gdgly/itr-201c/README.md

#ITR-201C
* 该项目是定制产品，产品名称为*变压器免维护呼吸器*，型号为*ITR-201C*。
* 目前产品设计到_V2.0_版本，按照新的需求，增加了液晶显示等内容，
  并且将核心板由原来的ARM9改为Cortex-A8。
