gdgly/itr-201c/SCH_160725/ITR-201C_FB_V20_160725/Visio-面板示意图_160726.pdf

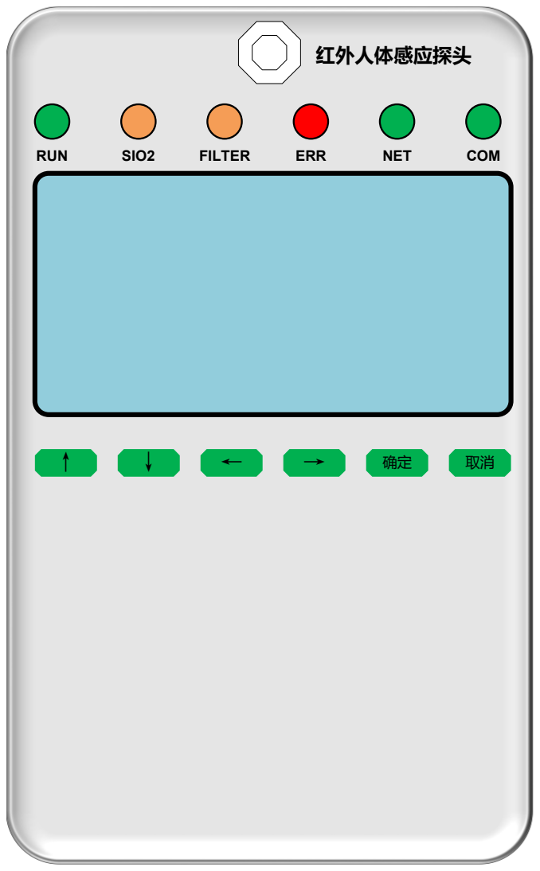
[picture p2: figure]
RUN; SIO2; FILTER; ERR; NET; COM; 红外人体感应探头

说明：
1、面板上一共配置6路指示灯，均采用直径
3mm指示灯。指示灯定义为：
RUN：运行指示灯
SIO2：硅胶加热器加热指示灯
FILTER：金属滤网加热器加热指示灯
ERR：系统错误指示灯
NET：以太网通讯指示灯
COM：RS485通讯指示灯
2、液晶屏采用3.5吋TFT真彩屏。
3、按键一共6个，分别为：
上、下、左、右和确定、取消键。
4、红外人体感应探头为白色圆形。当探测到
人体遮挡时，自动点亮液晶屏。
