gdgly/itr-201c/结构图_161019/ITR-201C_FB.dxf

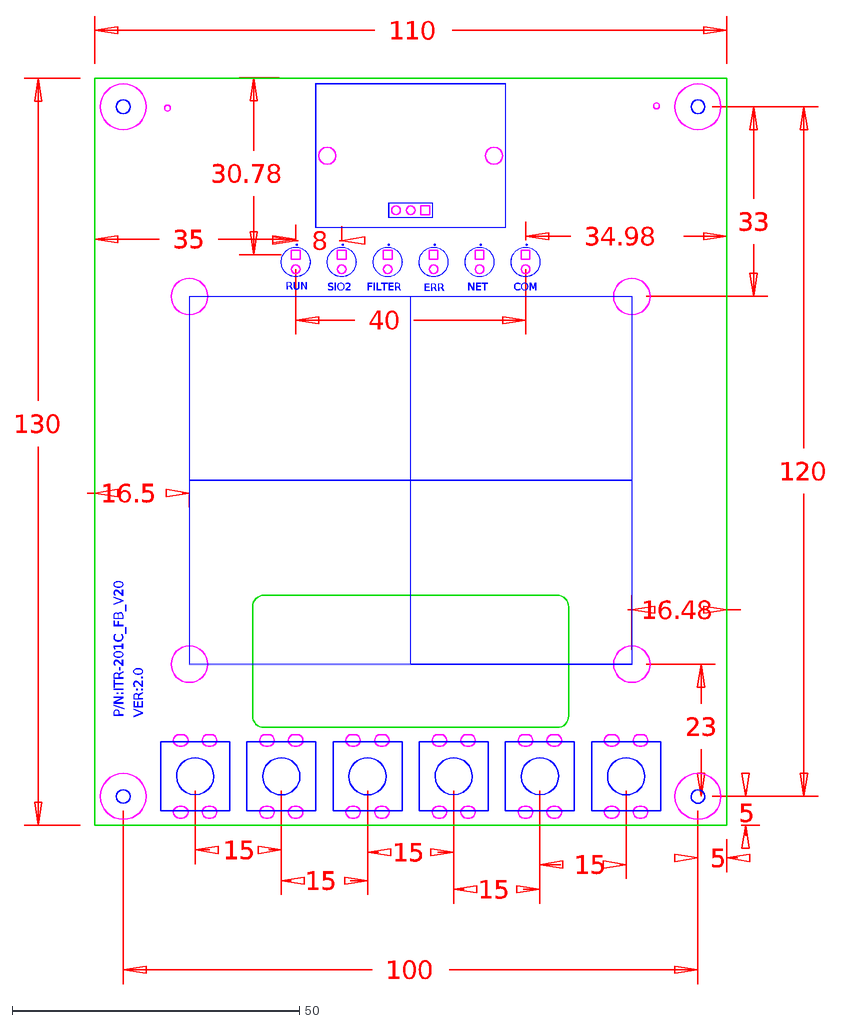
[picture p3: CAD file, 2016-10-24]
结构图_161019/ITR-201C_FB.dxf
33
5
23
30.78
35
34.98
40
8
16.5
16.48
120
100
15
110
130
COM
NET
ERR
FILTER
SIO2
RUN
VER:2.0
P/N:ITR-201C_FB_V20
