gdgly/itr-201c/SCH_160725/ITR-201C_FB_V20_160725/itr-201c_fb_V2.0_160812.pdf

D | D
C | C
B | B
A | A
2.0 | FEATURE CHANGES 1、产品升级至V2.0版。 2、需要增加液晶显示电路。整体架构重新设计。 | 07/23/16 | Jason
REV | DESCRIPTION | DATE | BY
1.0 | 04/20/16 | Jason

## Jason

# CONTENTS

PAGE NO. | SCHEMATIC PAGE
1 | 封面
2 | 接插件：1 * 40pin 双排2.54mm简牛插针
3 | LCD液晶屏电路
4 | 矩阵键盘电路
5 | LED指示灯输出电路
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
标记 标记 标记 | 数量更改单号签名日期 更改 数量更改单号签名日期 更改 数量更改单号签名日期 更改 | | | 更改 更改 更改 标记 标记 标记 | 数量更改单号 数量更改单号 数量更改单号 | | 签名 签名日期 更改标记 数量更改单号 签名 签名日期 更改标记 数量更改单号 签名 签名日期 更改标记 数量更改单号 | 日期 日期 日期
拟制 拟制 拟制 | | Jason.Wang Jason.Wang Jason.Wang | COVER COVER COVER | | | ITR-201C ITR-201C ITR-201C
审核 审核 审核 | | <审核> <审核> <审核>
批准 | <批准>
版本 | 第　　张 | 共　　张
V2.0 V2.0 V2.0 | 1 1 1 | 5 5 5

# 标准化

D | D

# 采用40pin双排简牛插座

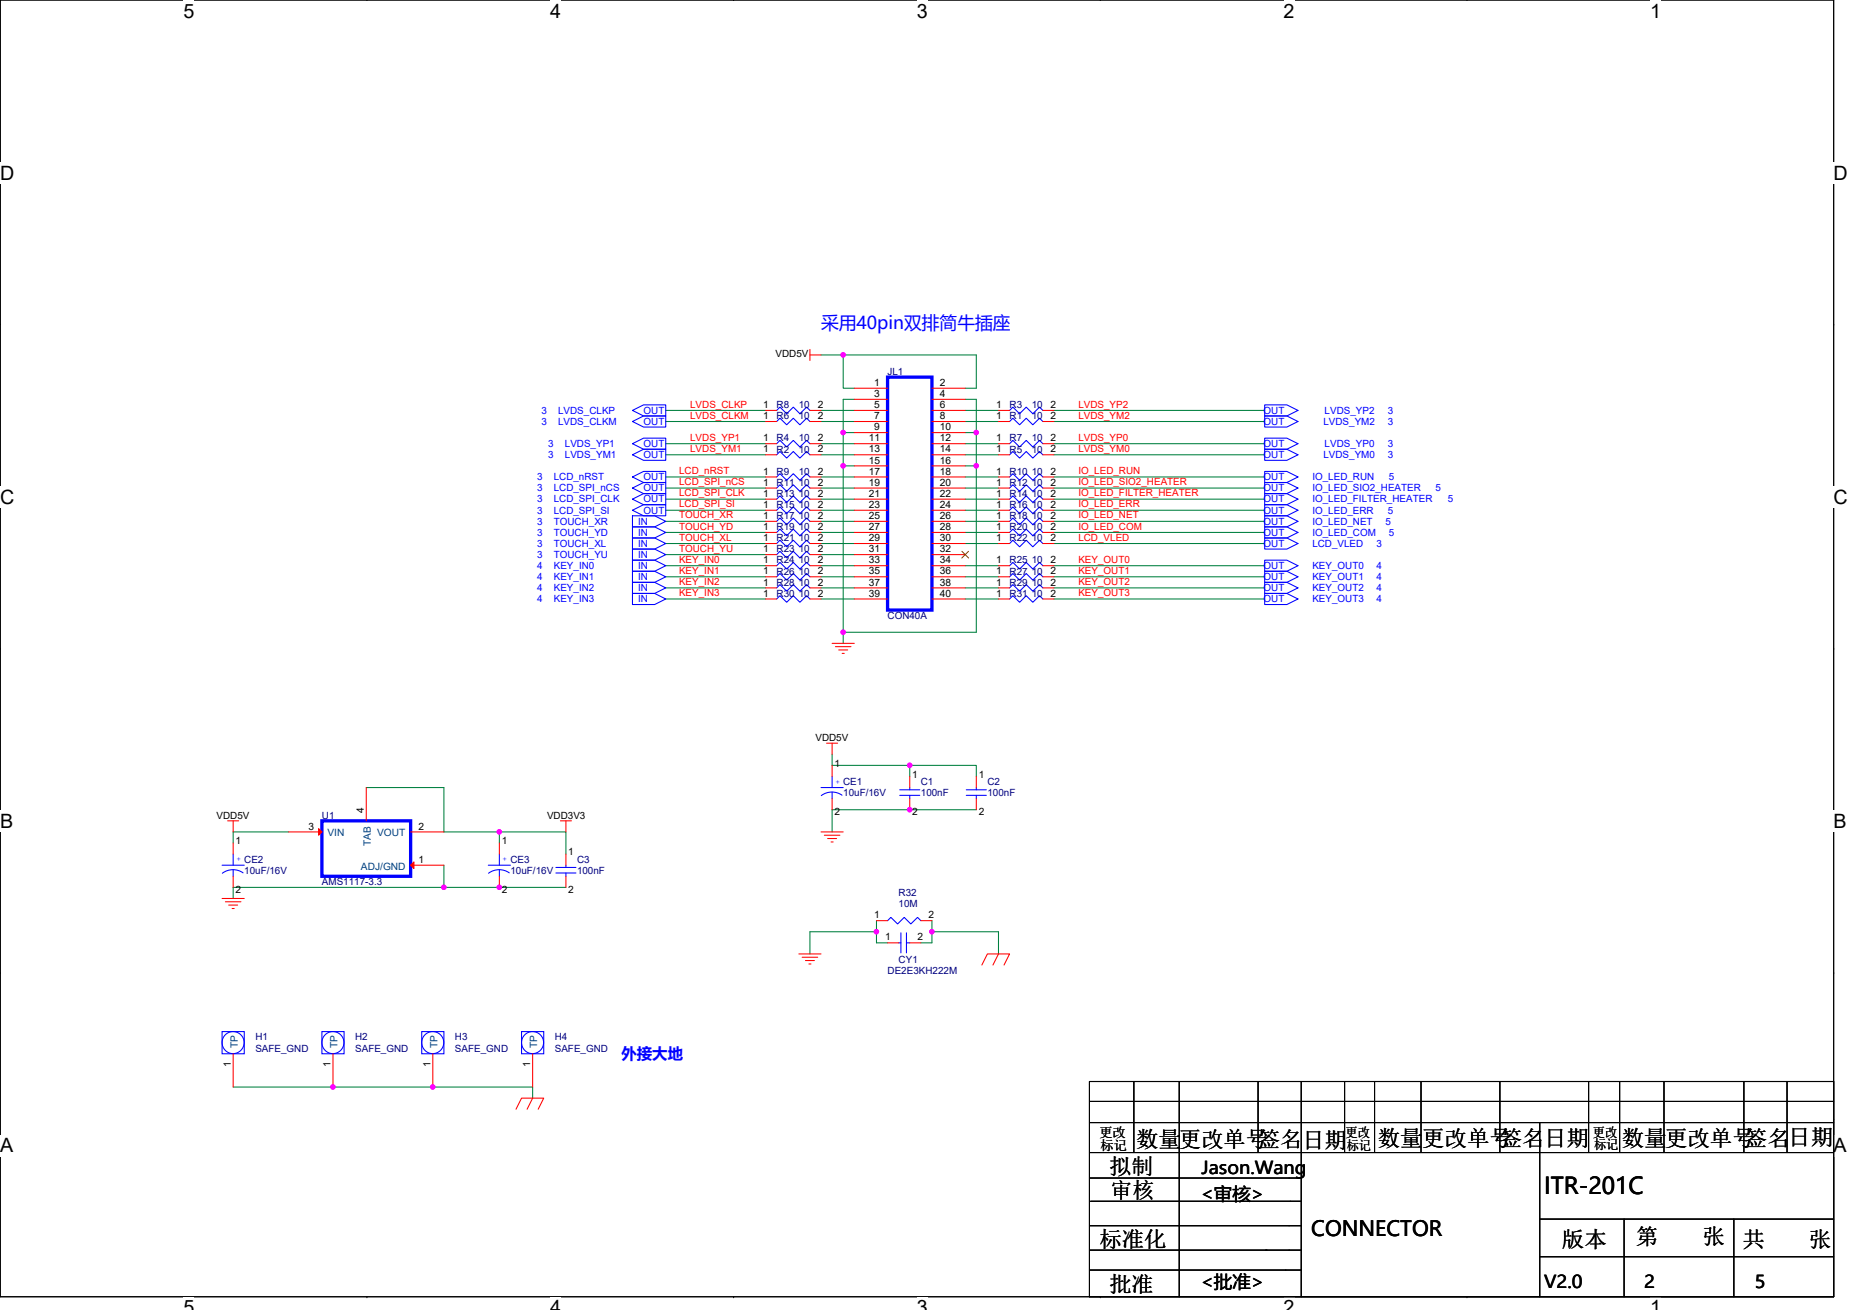
[picture p4: page 2]

标记 标记 标记 | 数量更改单号签名日期 更改 数量更改单号签名日期 更改 数量更改单号签名日期 更改 | | | 更改 更改 更改 标记 标记 标记 | 数量更改单号 数量更改单号 数量更改单号 | | 签名 签名日期 更改标记 数量更改单号 签名 签名日期 更改标记 数量更改单号 签名 签名日期 更改标记 数量更改单号 | 日期 日期 日期
拟制 拟制 拟制 | | Jason.Wang Jason.Wang Jason.Wang | CONNECTOR CONNECTOR CONNECTOR | | | ITR-201C ITR-201C ITR-201C
审核 审核 审核 | | <审核> <审核> <审核>

D | D
D0 24 | GND | 25 D1 | 26 D2 | 27 VCC | 28 D3 | 29 D4 | 30 D5 | 31 GND | 32 D6 | 33 D7 | 34 D8 | 35 VCC | 36 D9 | 37 GND | 38 D10 | 39 D11 | 40 D12 | 41 VCC | 42 D13 | 43 GND | 44 D14 | 45 D15 | 46 D16 | 47 VCC | 48

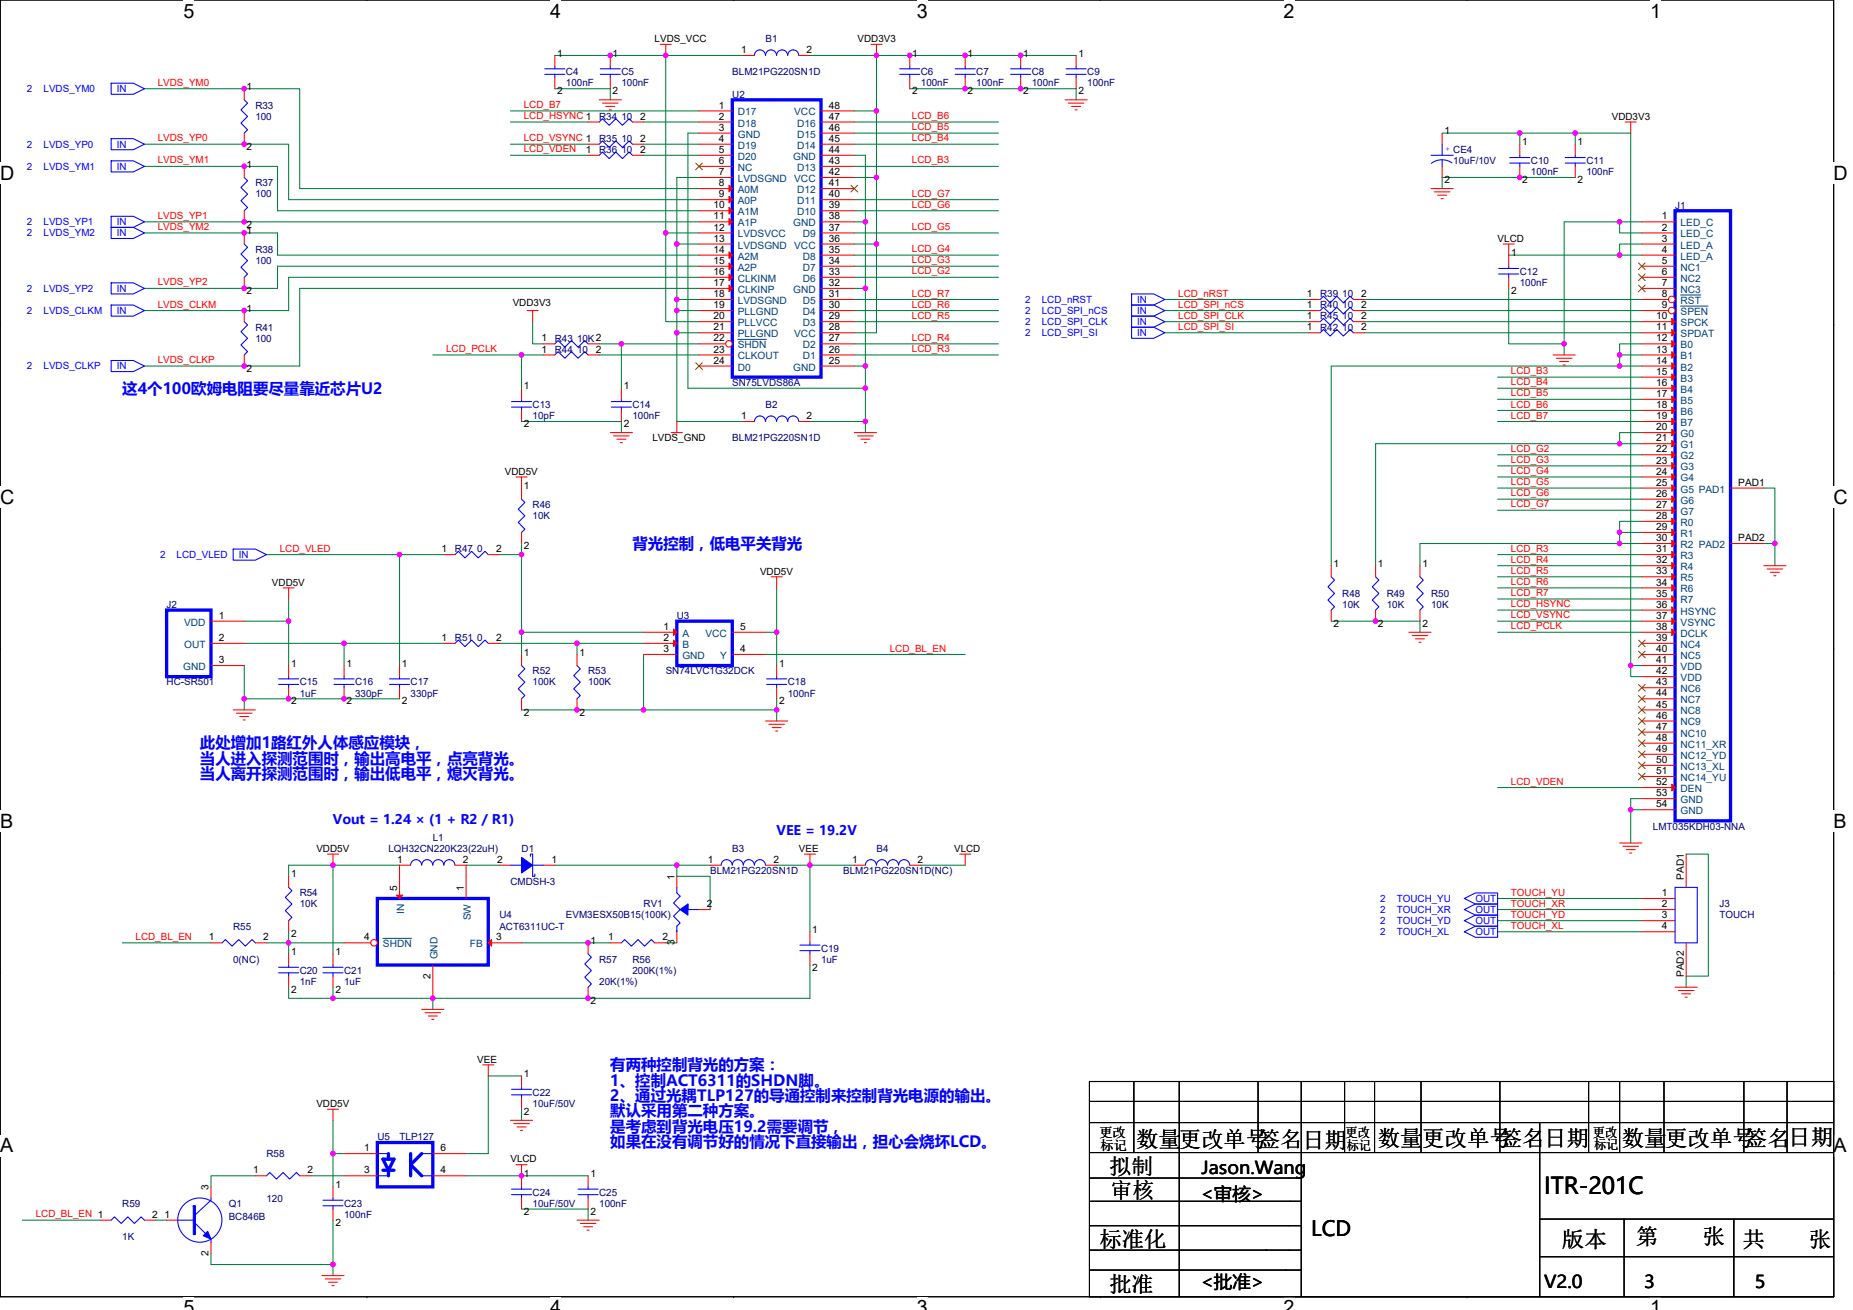
[picture p5: page 3]

CLKINM 16

VDD3V3 | LVDSGND 18

标记 标记 标记 | 数量更改单号签名日期 更改 数量更改单号签名日期 更改 数量更改单号签名日期 更改 | | | 更改 更改 更改 标记 标记 标记 | 数量更改单号 数量更改单号 数量更改单号 | | 签名 签名日期 更改标记 数量更改单号 签名 签名日期 更改标记 数量更改单号 签名 签名日期 更改标记 数量更改单号 | 日期 日期 日期
拟制 拟制 拟制 | | Jason.Wang Jason.Wang Jason.Wang | LCD LCD LCD | | | ITR-201C ITR-201C ITR-201C
审核 审核 审核 | | <审核> <审核> <审核>

D | D

# KEYBOARD

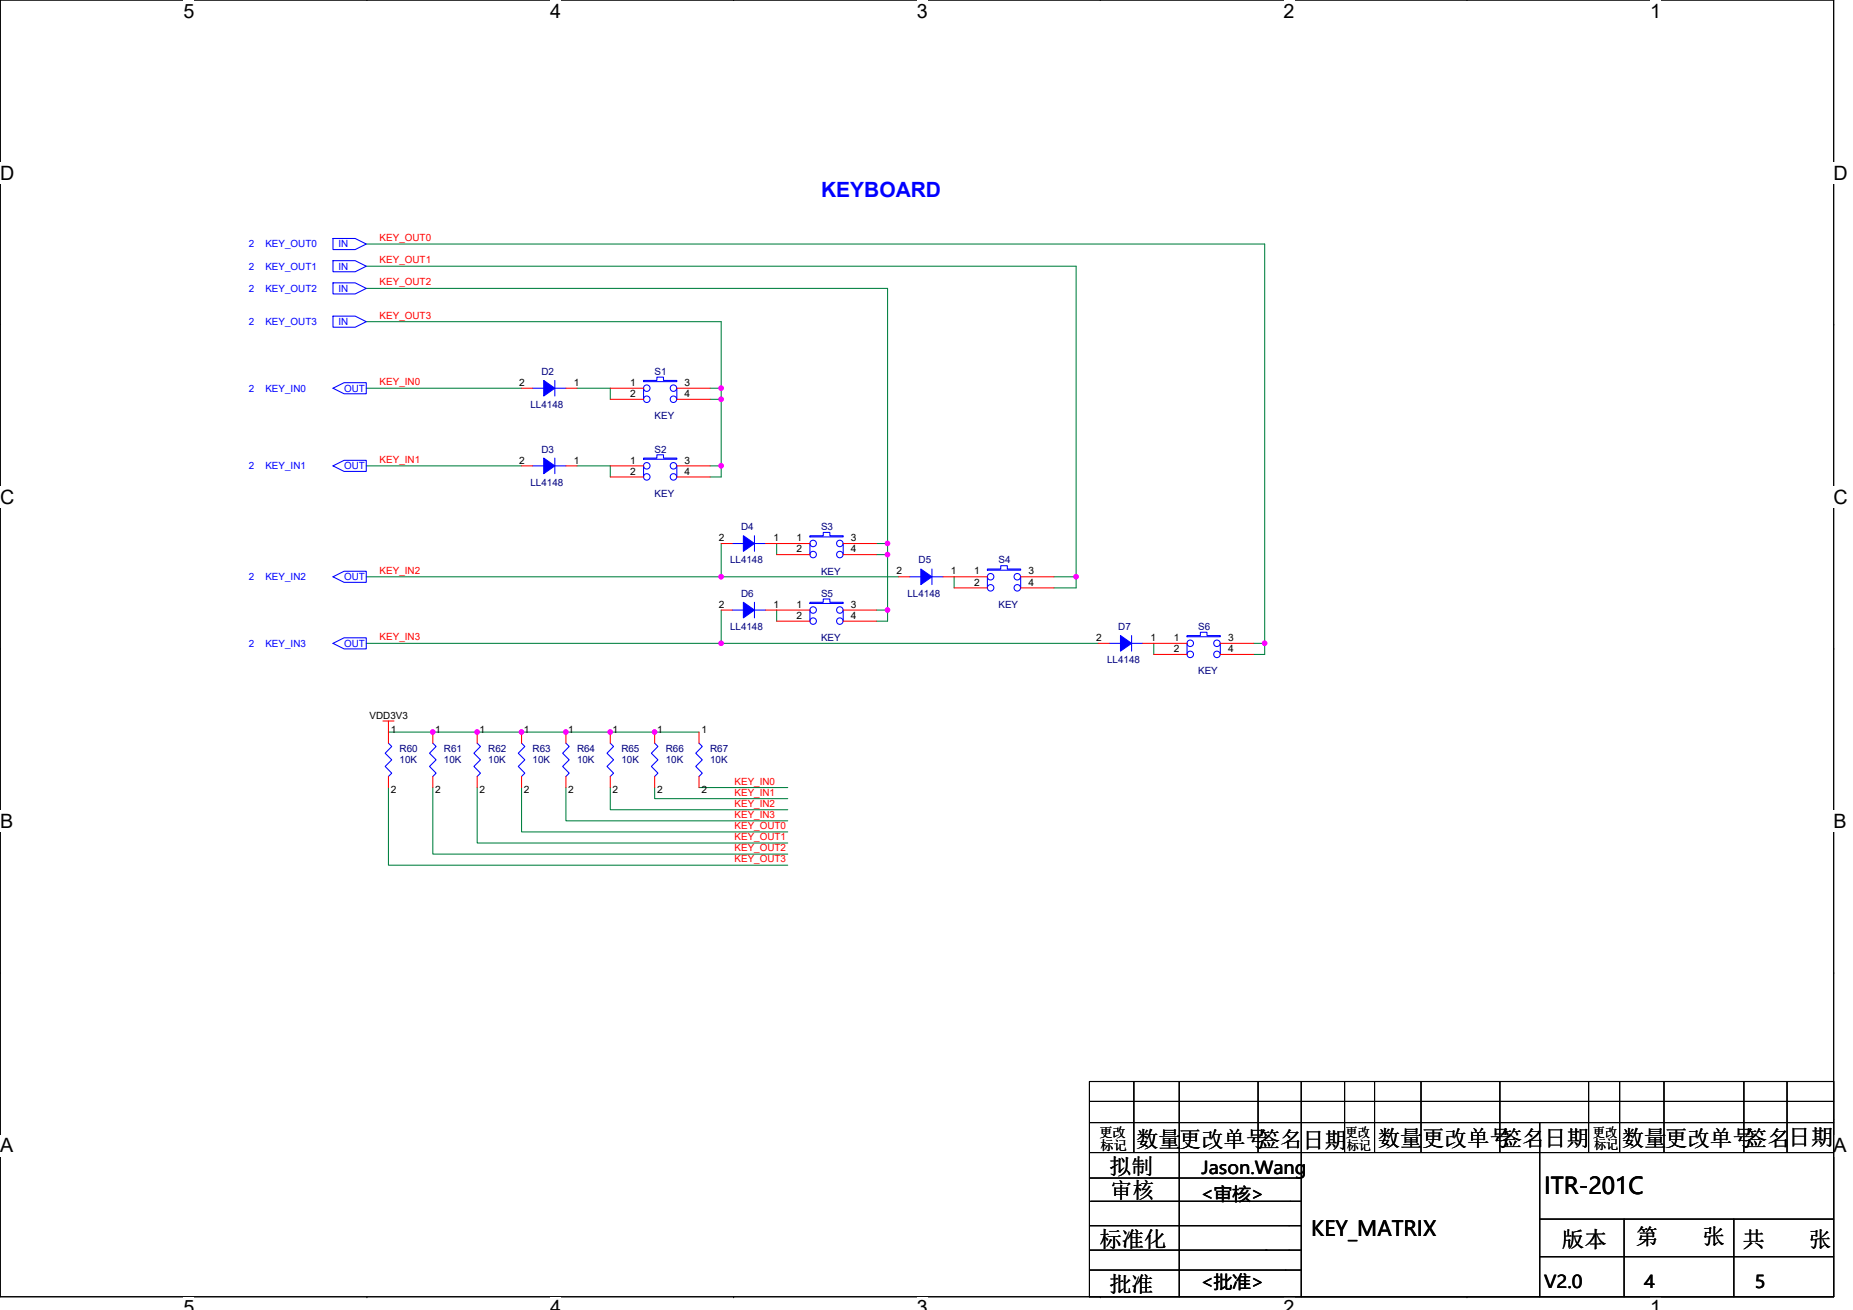
[picture p6: page 4]

标记 标记 标记 | 数量更改单号签名日期 更改 数量更改单号签名日期 更改 数量更改单号签名日期 更改 | | | 更改 更改 更改 标记 标记 标记 | 数量更改单号 数量更改单号 数量更改单号 | | 签名 签名日期 更改标记 数量更改单号 签名 签名日期 更改标记 数量更改单号 签名 签名日期 更改标记 数量更改单号 | 日期 日期 日期
拟制 拟制 拟制 | | Jason.Wang Jason.Wang Jason.Wang | KEY_MATRIX KEY_MATRIX KEY_MATRIX | | | ITR-201C ITR-201C ITR-201C
审核 审核 审核 | | <审核> <审核> <审核>

D | D

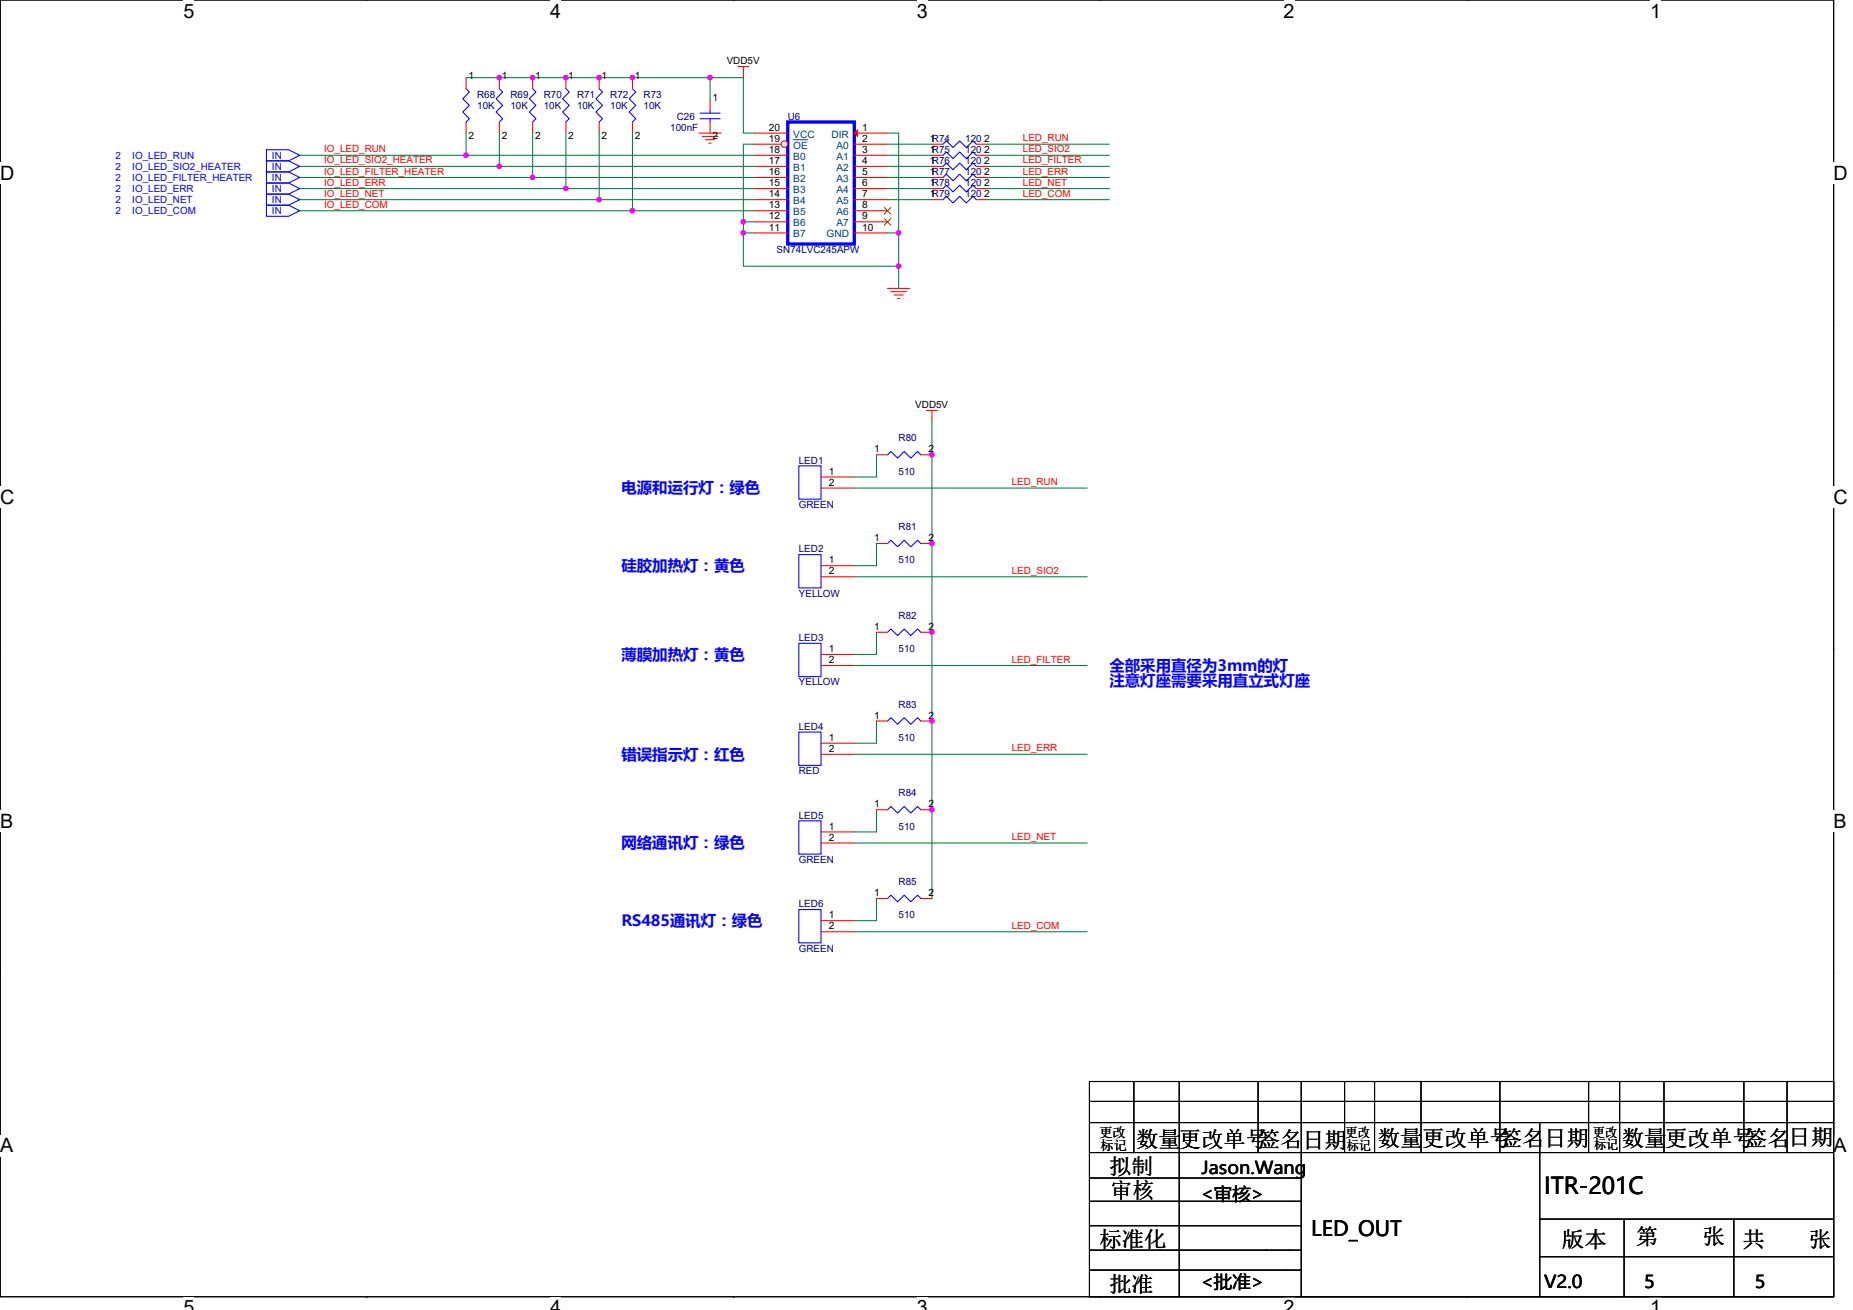
[picture p7: page 5]

标记 标记 标记 | 数量更改单号签名日期 更改 数量更改单号签名日期 更改 数量更改单号签名日期 更改 | | | 更改 更改 更改 标记 标记 标记 | 数量更改单号 数量更改单号 数量更改单号 | | 签名 签名日期 更改标记 数量更改单号 签名 签名日期 更改标记 数量更改单号 签名 签名日期 更改标记 数量更改单号 | 日期 日期 日期
拟制 拟制 拟制 | | Jason.Wang Jason.Wang Jason.Wang | LED_OUT LED_OUT LED_OUT | | | ITR-201C ITR-201C ITR-201C
审核 审核 审核 | | <审核> <审核> <审核>
