gdgly/itr-201c/SCH_160725/ITR-201C_MB_V20_160727/ITR-201C_MB_V20_160727.pdf

D | D
C | C
B | B
A | A

1.1

1.0 | FEATURE CHANGES 1、完成1.0版本原理图设计。 | 07/27/16 | Jason
REV | DESCRIPTION | DATE | BY

# CONTENTS

PAGE NO. | SCHEMATIC PAGE
1 | 封面
2 | 系统逻辑框图
3 | 核心板接插件1：LOCAL_BUS
4 | 核心板接插件2：各种外设
5 | 地址线/数据线扩展
6 | CPLD：采用EPM570
7 | LVDS 显示驱动电路
8 | 一路以太网PHY：采用KSZ8041FTL
9 | RJ45
10 | RS485接口电路
11 | 温湿度检测电路
12 | 继电器控制电路
13 | 继电器输出接口电路
14 | 到面板40pin接口
15 | 其它接口电路
16 | 系统输入电源电路
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
标记 标记 标记 | 数量更改单号签名日期 更改 数量更改单号签名日期 更改 数量更改单号签名日期 更改 | | | 更改 更改 更改 标记 标记 标记 | 数量更改单号 数量更改单号 数量更改单号 | | 签名 签名日期 更改标记 数量更改单号 签名 签名日期 更改标记 数量更改单号 签名 签名日期 更改标记 数量更改单号 | 日期 日期 日期
拟制 拟制 拟制 | | Jason.Wang Jason.Wang Jason.Wang | COVER COVER COVER | | | ITR-201C ITR-201C ITR-201C
审核 审核 审核 | | <审核> <审核> <审核>
批准 | <批准>
版本 | 第　　张 | 共　　张
V2.0 V2.0 V2.0 | 1 1 1 | 16 16 16

# 标准化

D | D
C | C
B | B
A | A
LOCAL_BUS | SWA3300

# LVDS

# KSZ8041FTL

# CPLD EPM570T144

# TEMP & HUMIDITY

# DIO

# DO X 4

RJ45

USB 2.0 | USB
UART X 2 | RS485
标记 标记 标记 | 数量更改单号签名日期 更改 数量更改单号签名日期 更改 数量更改单号签名日期 更改 | | | 更改 更改 更改 标记 标记 标记 | 数量更改单号 数量更改单号 数量更改单号 | | 签名 签名日期 更改标记 数量更改单号 签名 签名日期 更改标记 数量更改单号 签名 签名日期 更改标记 数量更改单号 | 日期 日期 日期
拟制 拟制 拟制 | | Jason.Wang Jason.Wang Jason.Wang | SYS_LOGIC SYS_LOGIC SYS_LOGIC | | | ITR-201C ITR-201C ITR-201C
审核 审核 审核 | | <审核> <审核> <审核>
V2.0 | 2 | 16
V2.0 | 2 | 16
V2.0 | 2 | 16

D | D

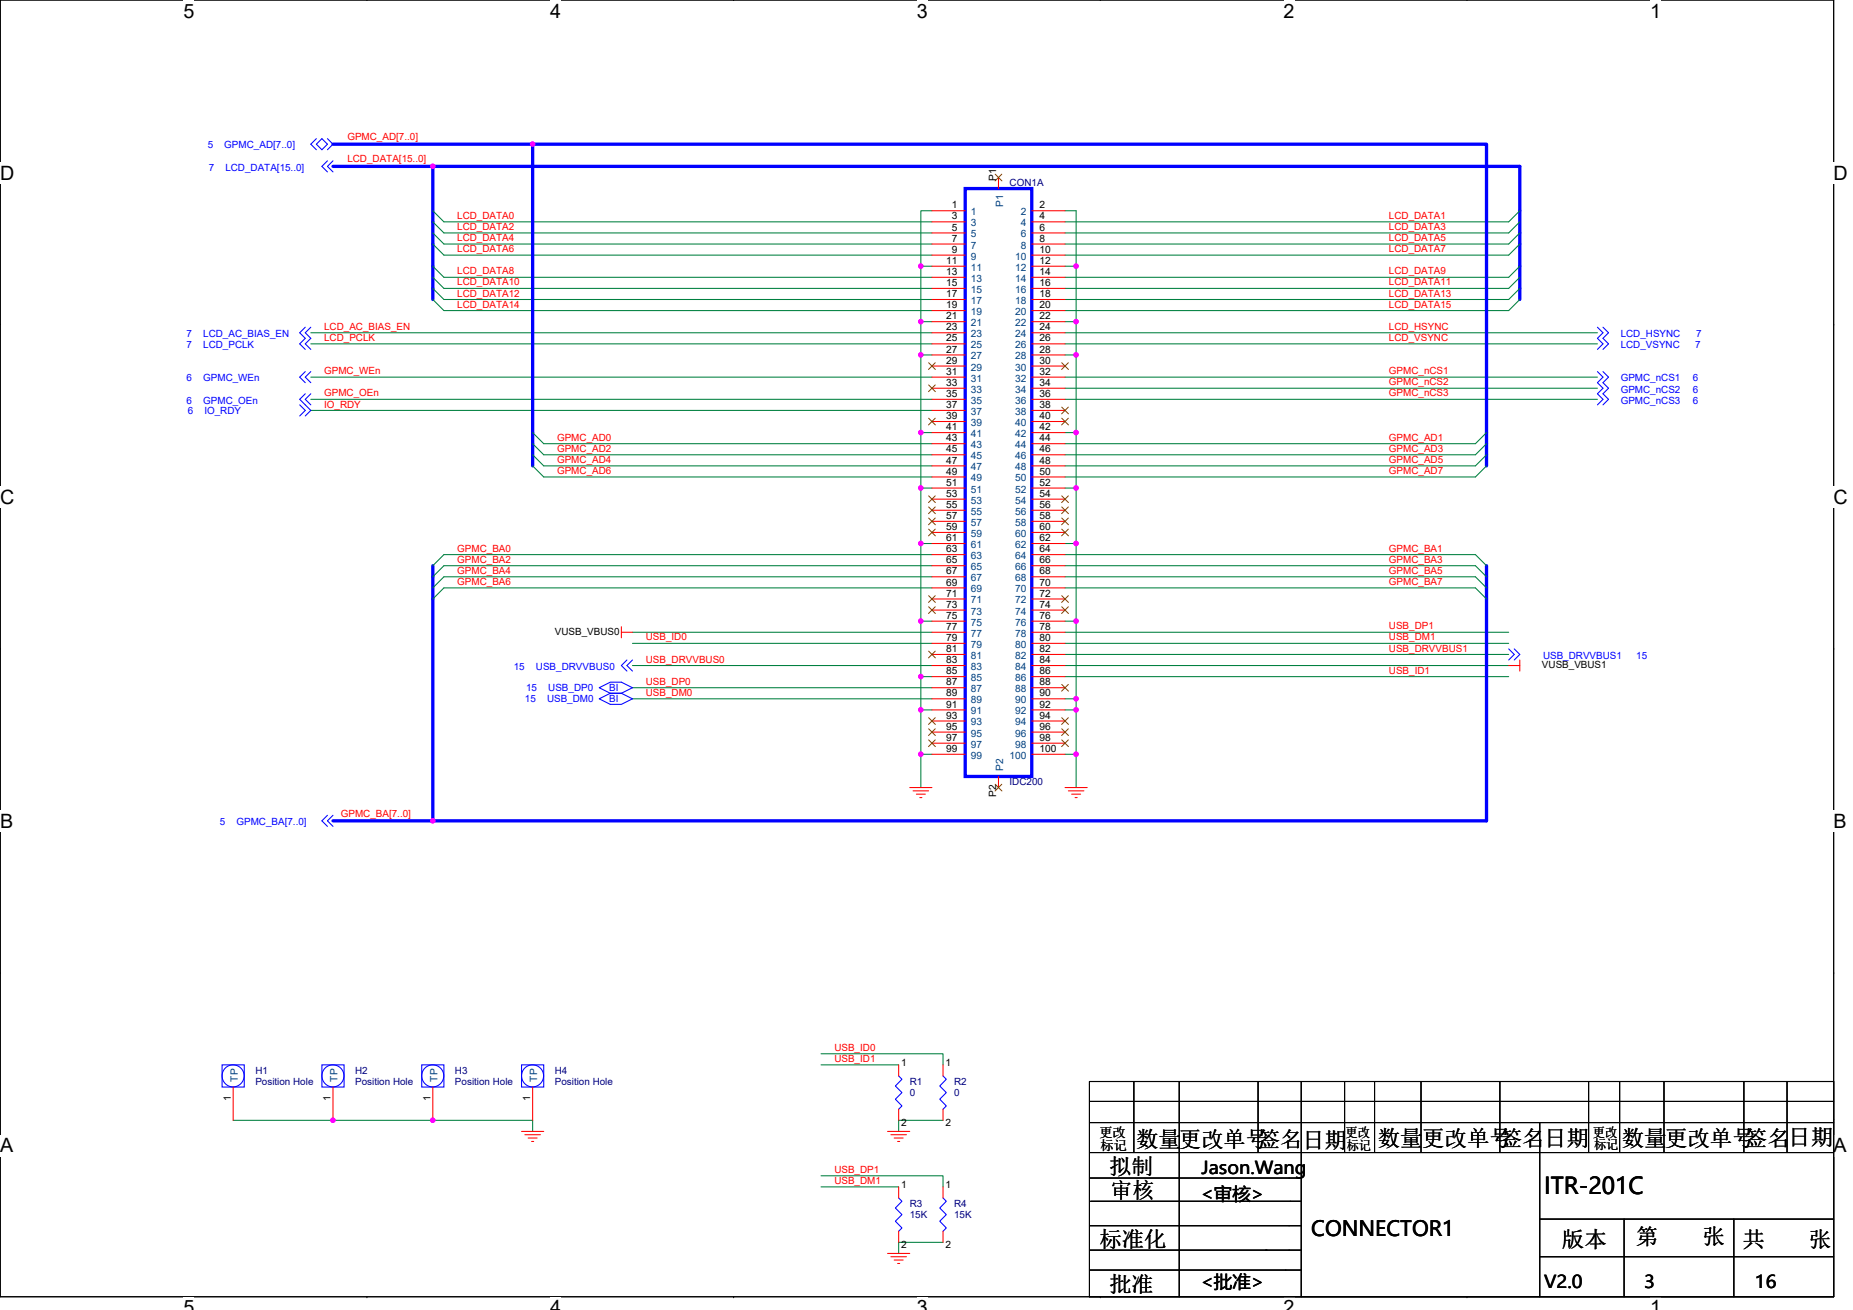
[picture p8: page 3]
USB_ID1; USB_ID0; LCD_DATA0 LCD_DATA2 LCD_DATA4 LCD_DATA6; LCD_DATA8 LCD_DATA10 LCD_DATA12 LCD_DATA14; LCD_DATA9 LCD_DATA11 LCD_DATA13 LCD_DATA15; LCD_DATA1 LCD_DATA3 LCD_DATA5 LCD_DATA7; LCD_DATA[15..0]; LCD_PCLK; LCD_AC_BIAS_EN; LCD_HSYNC; LCD_VSYNC; GPMC_WEn; GPMC_OEn IO_RDY; GPMC_nCS1 GPMC_nCS2 GPMC_nCS3; GPMC_AD0 GPMC_AD2 GPMC_AD4 GPMC_AD6; GPMC_AD1 GPMC_AD3 GPMC_AD5 GPMC_AD7; GPMC_AD[7..0]; USB_DRVVBUS0; USB_DP0 USB_DM0; GPMC_BA0 GPMC_BA2; GPMC_BA6; GPMC_BA4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

Position Hole TP

拟制 拟制 拟制 | Jason.Wang Jason.Wang Jason.Wang | CONNECTOR1 CONNECTOR1 CONNECTOR1 | ITR-201C ITR-201C ITR-201C
审核 审核 审核 | <审核> <审核> <审核>

D | D

注意：

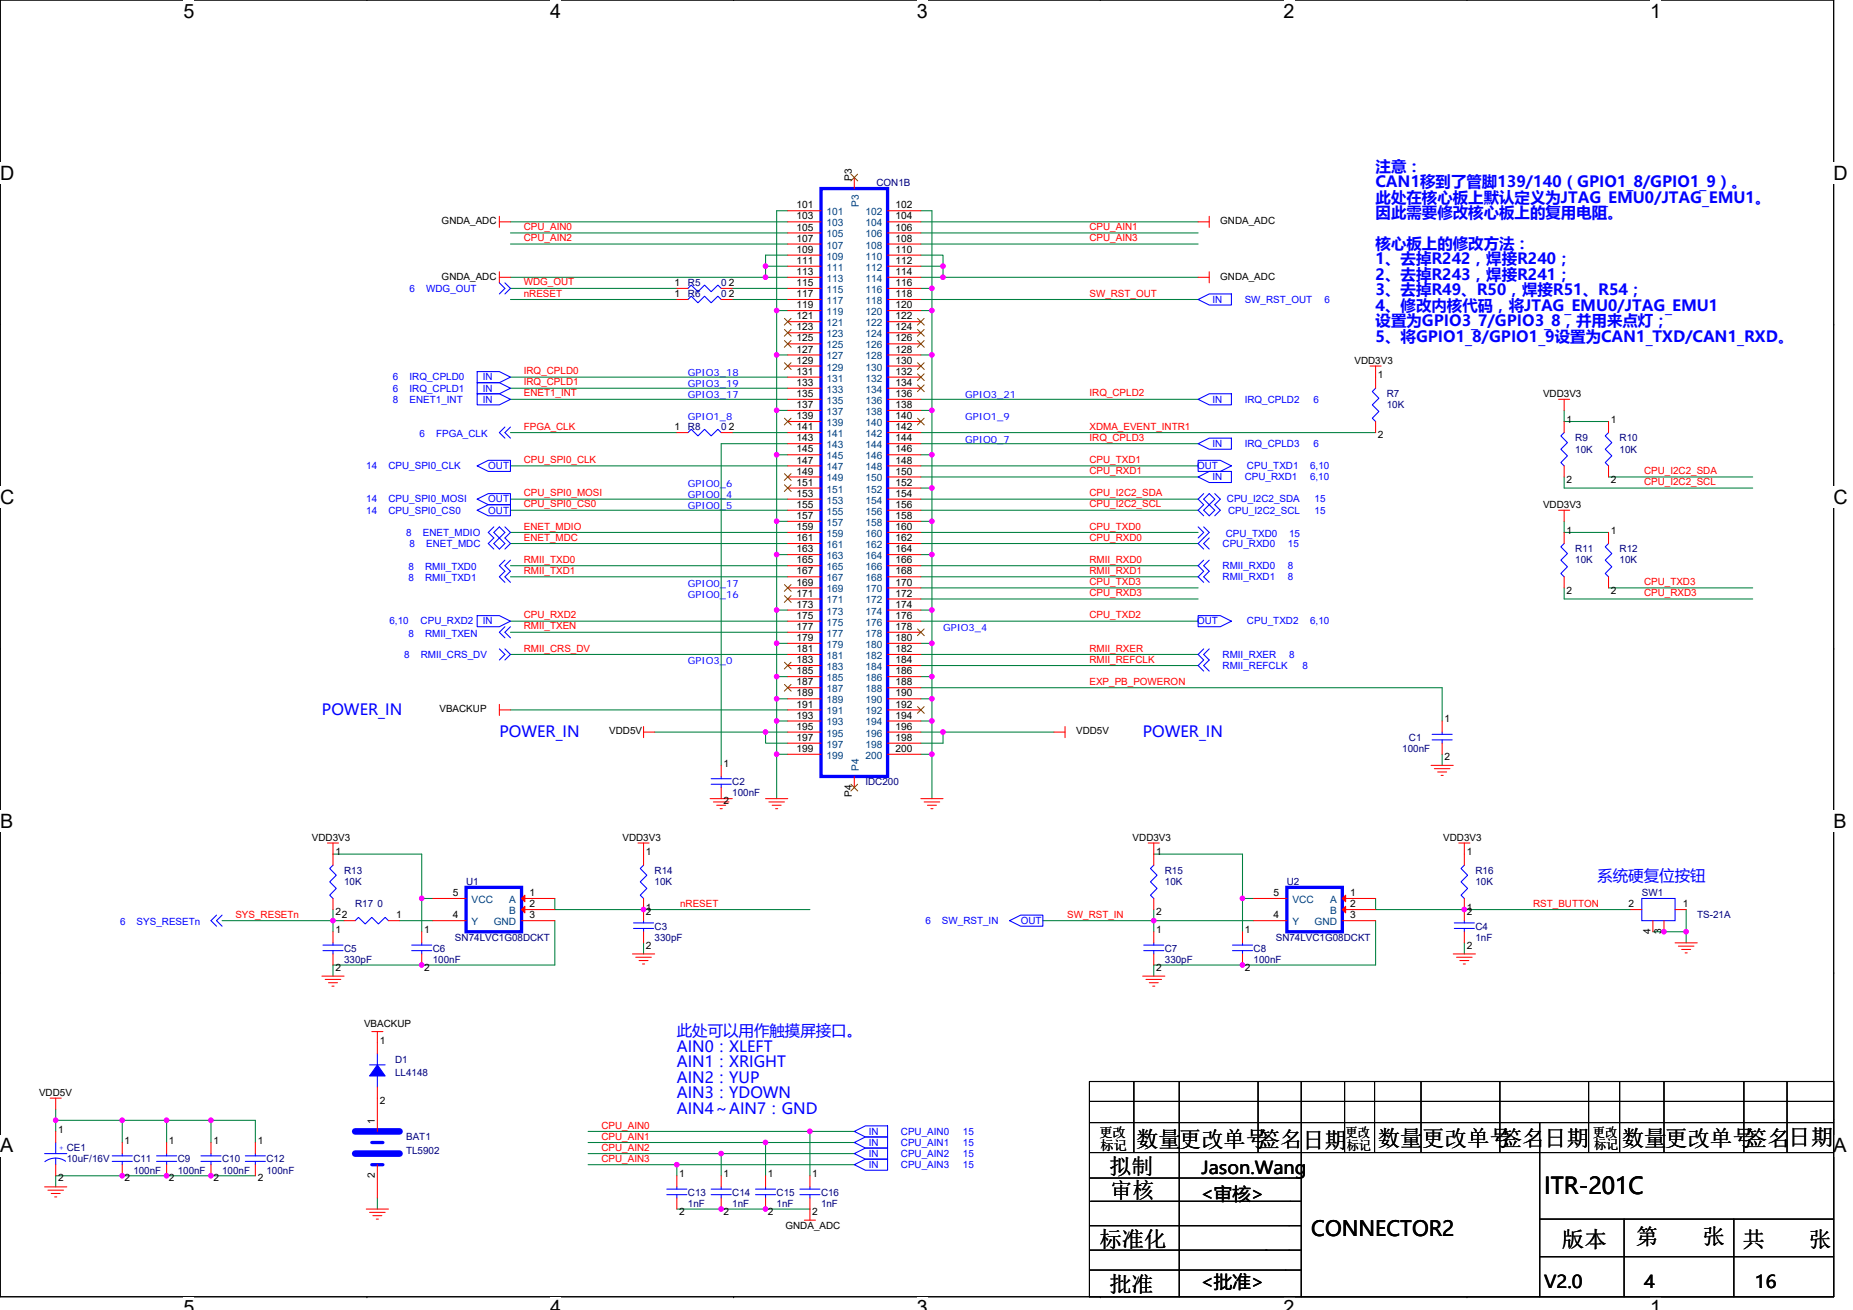
[picture p9: page 4]

拟制 拟制 拟制 | Jason.Wang Jason.Wang Jason.Wang | CONNECTOR2 CONNECTOR2 CONNECTOR2 | ITR-201C ITR-201C ITR-201C
审核 审核 审核 | <审核> <审核> <审核>

D | D

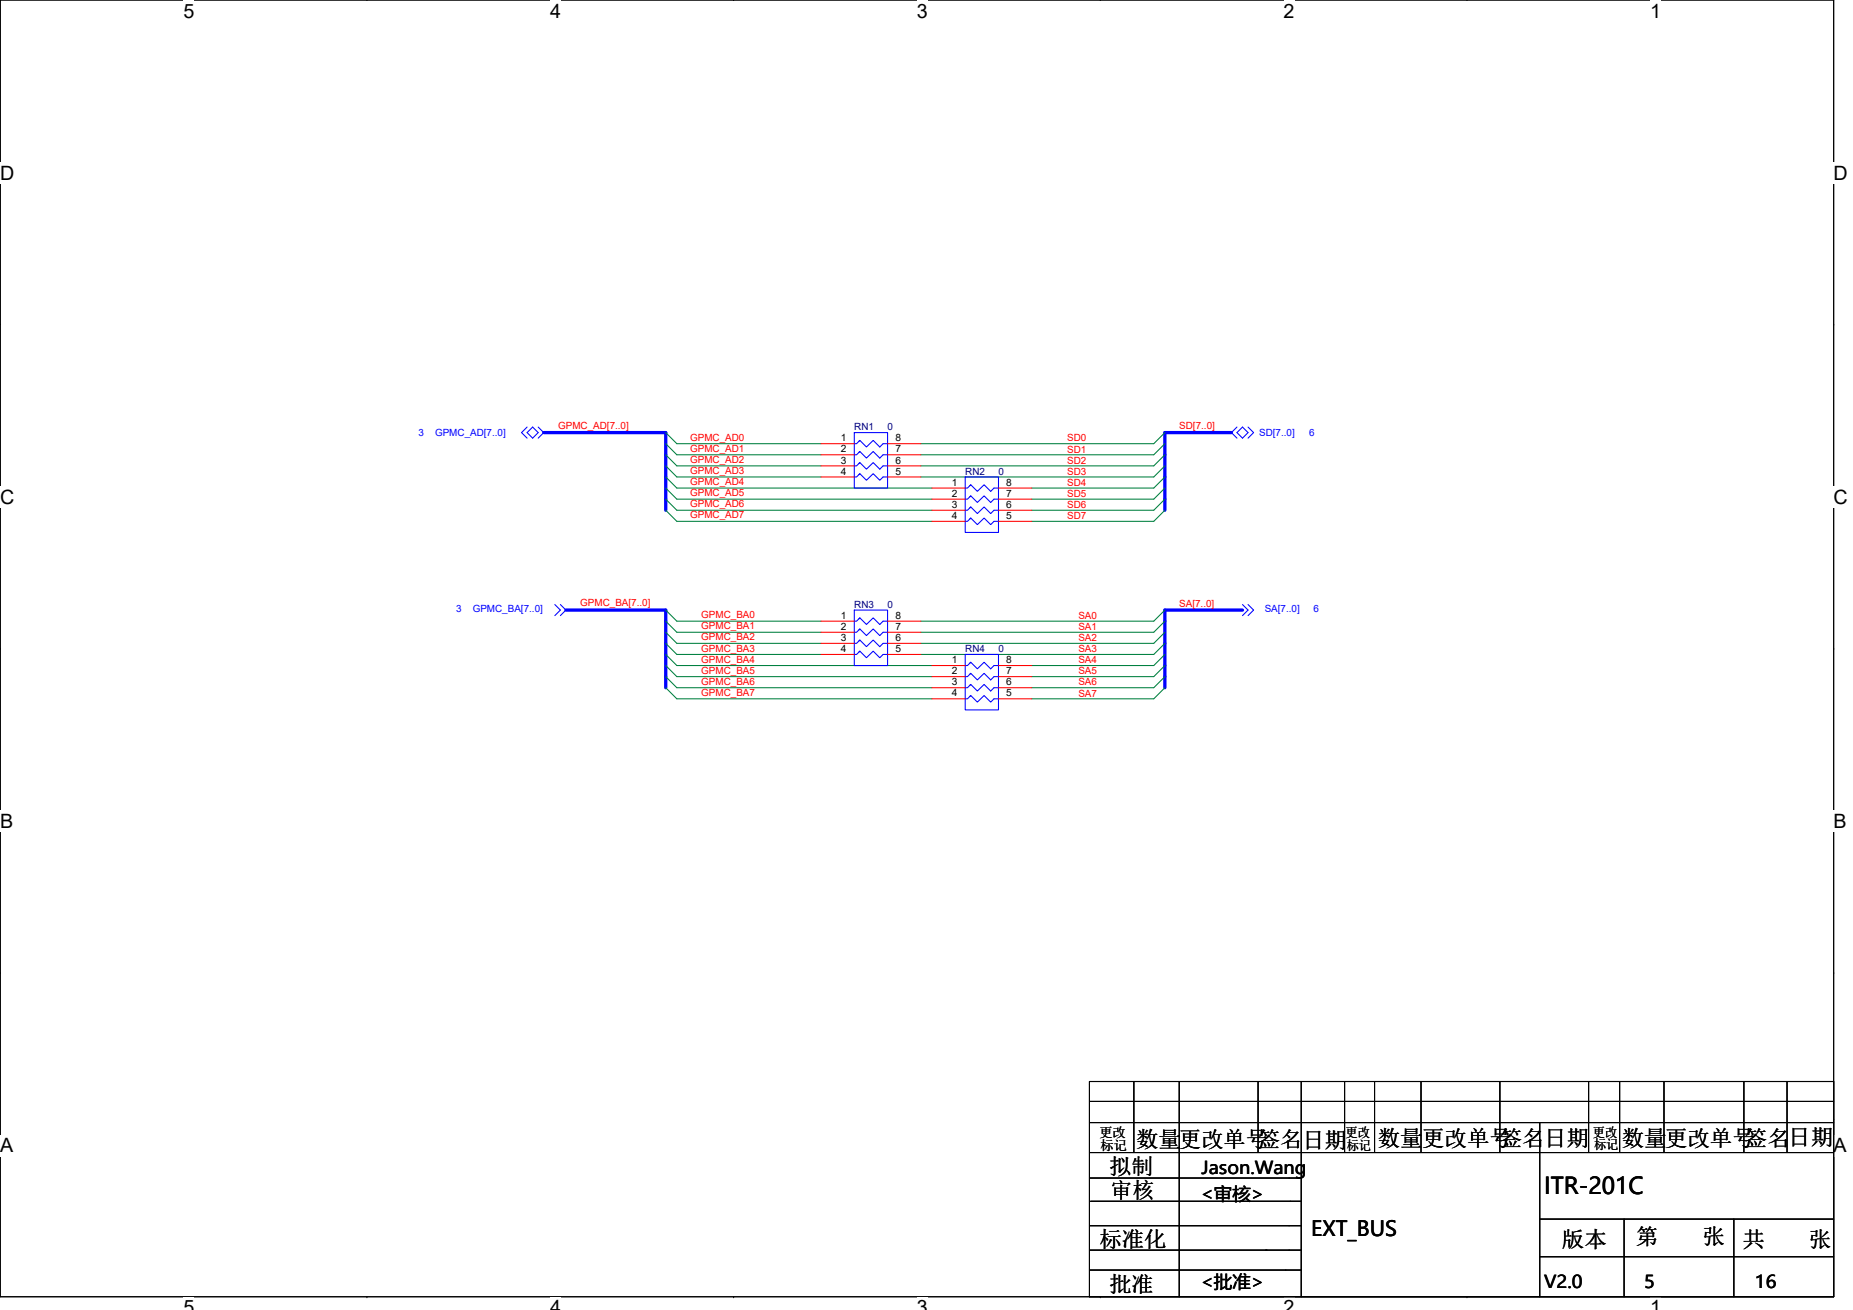
[picture p10: page 5]
GPMC_BA[7..0]; GPMC_BA0 GPMC_BA1 GPMC_BA2 GPMC_BA3 GPMC_BA4 GPMC_BA5 GPMC_BA6 GPMC_BA7; GPMC_AD0 GPMC_AD1 GPMC_AD2 GPMC_AD3 GPMC_AD4 GPMC_AD5 GPMC_AD6 GPMC_AD7; GPMC_AD[7..0]; 3 GPMC_BA[7..0]; 3 GPMC_AD[7..0]

标记 标记 标记 | 数量更改单号签名日期 更改 数量更改单号签名日期 更改 数量更改单号签名日期 更改 | | | 更改 更改 更改 标记 标记 标记 | 数量更改单号 数量更改单号 数量更改单号 | | 签名 签名日期 更改标记 数量更改单号 签名 签名日期 更改标记 数量更改单号 签名 签名日期 更改标记 数量更改单号 | 日期 日期 日期
拟制 拟制 拟制 | | Jason.Wang Jason.Wang Jason.Wang | EXT_BUS EXT_BUS EXT_BUS | | | ITR-201C ITR-201C ITR-201C
审核 审核 审核 | | <审核> <审核> <审核>

D

D

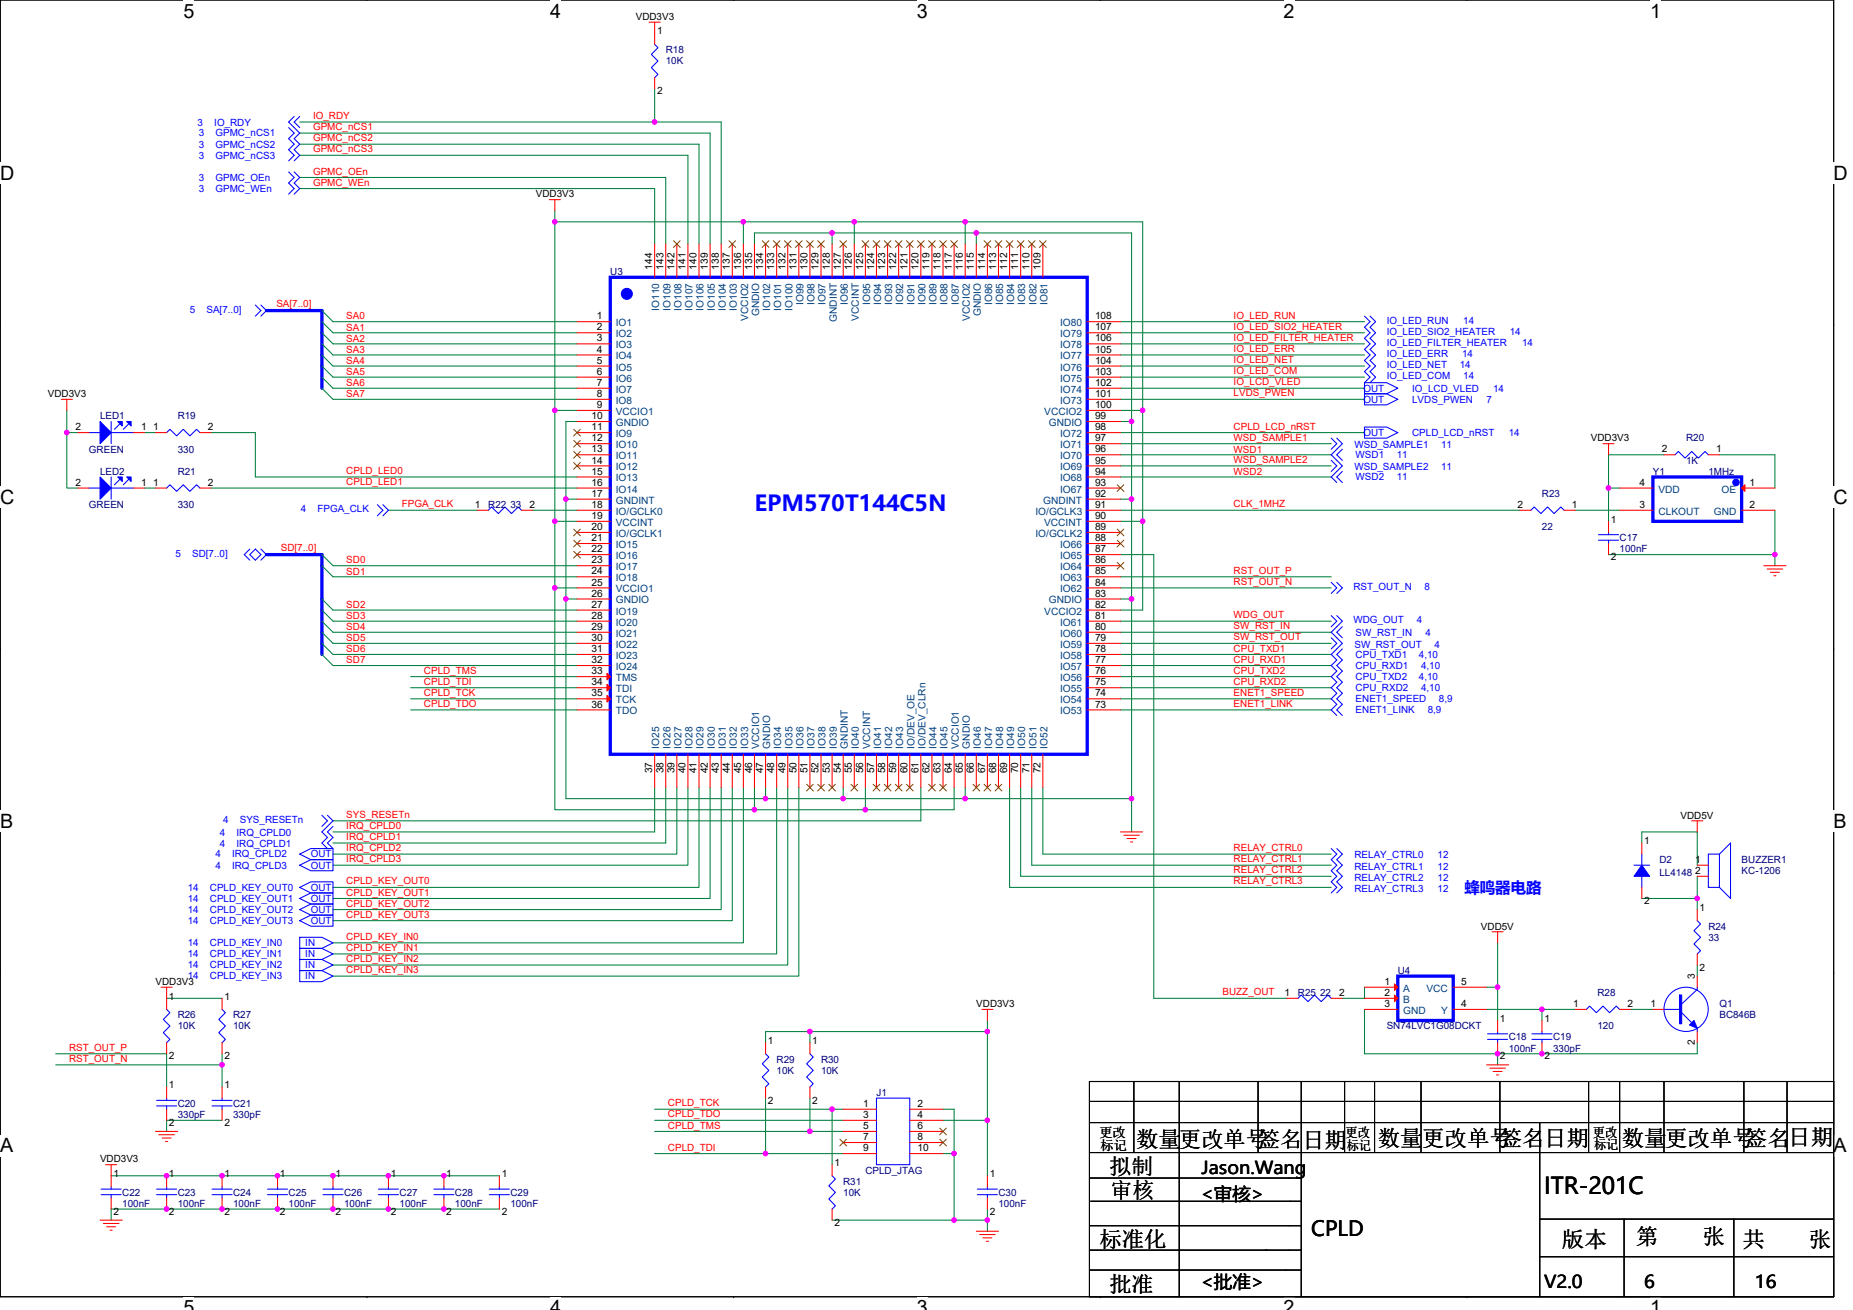
[picture p11: page 6]

D | D

注意：

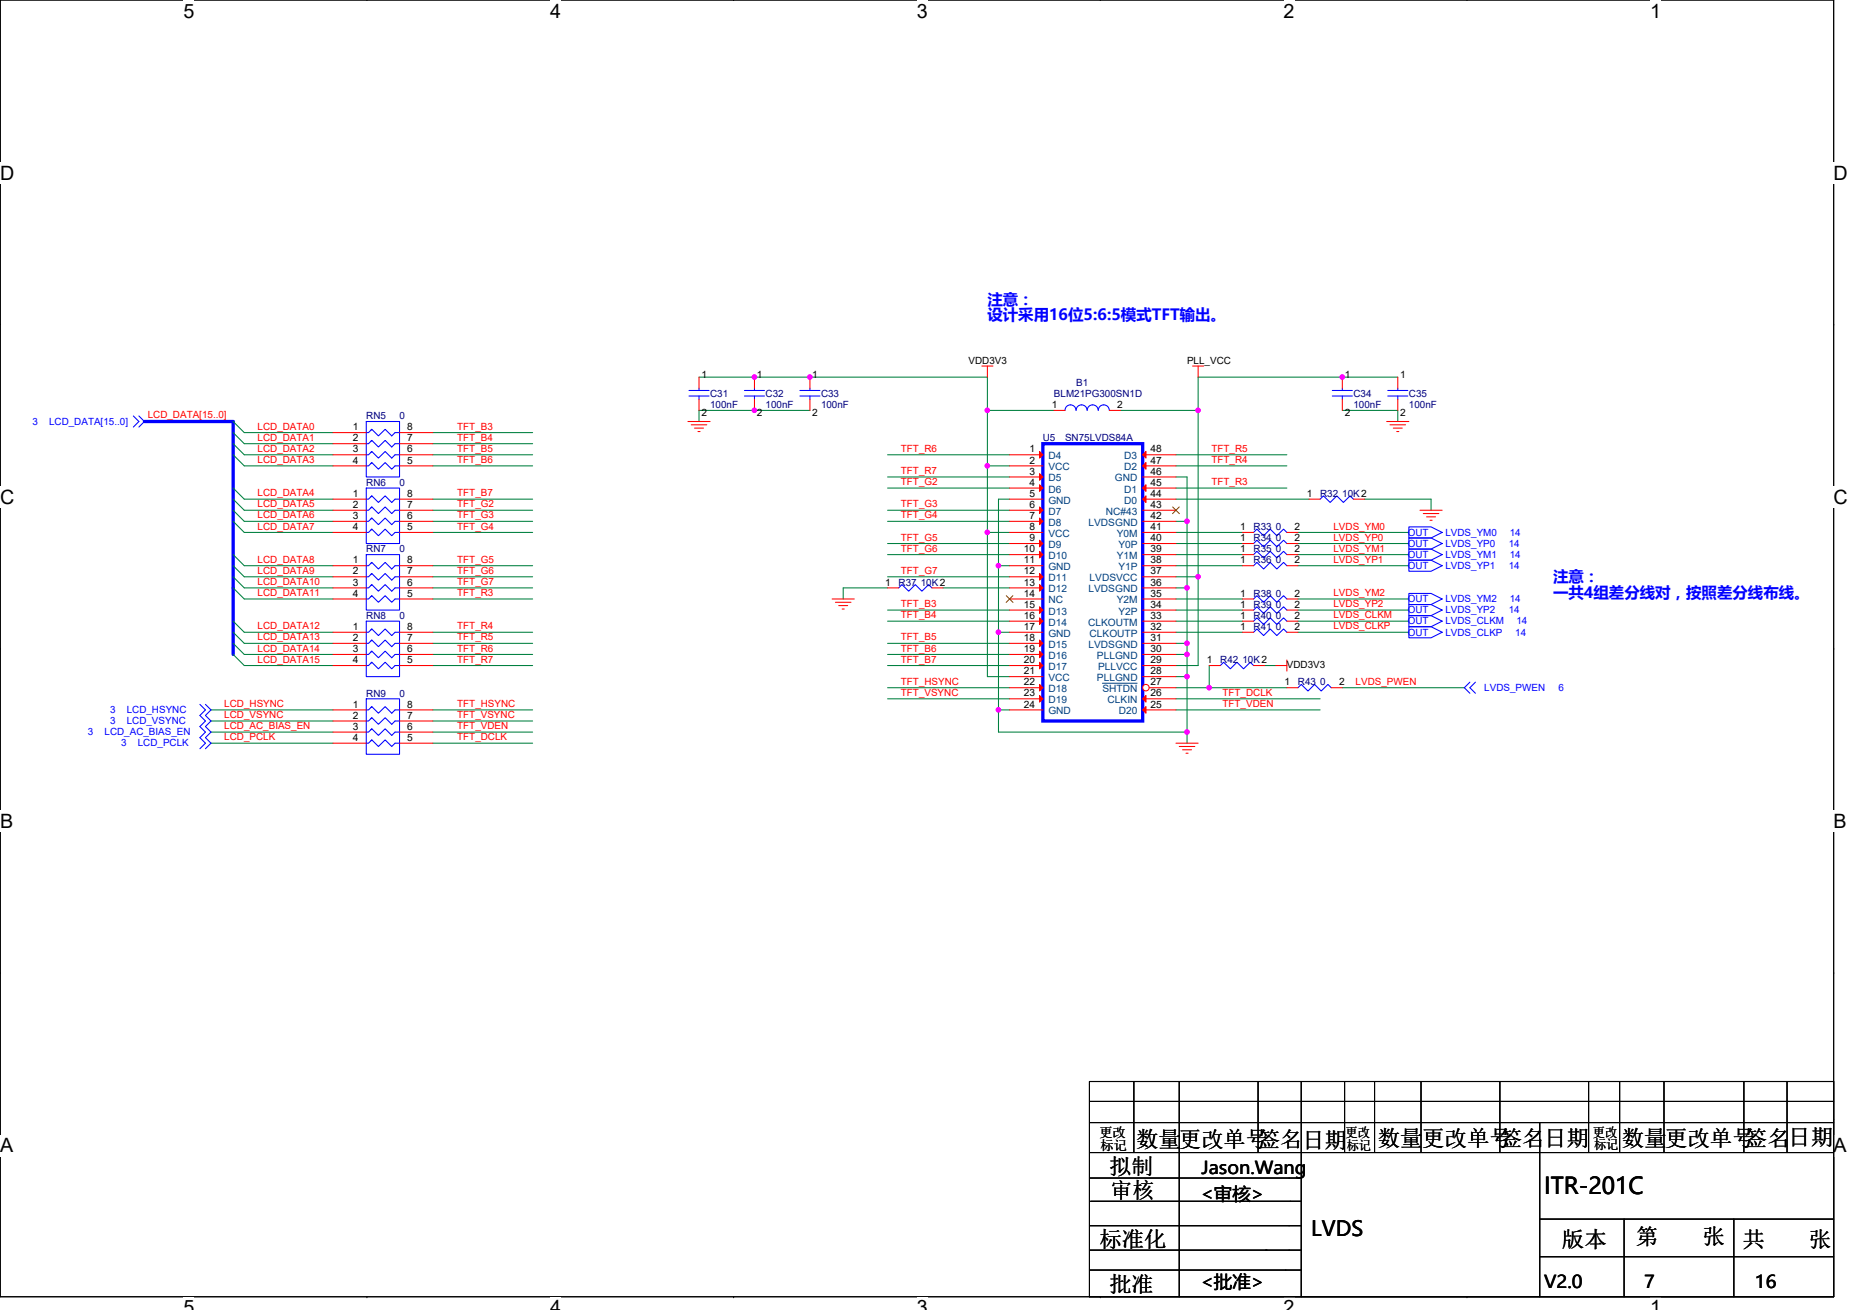
[picture p12: page 7]

标记 标记 标记 | 数量更改单号签名日期 更改 数量更改单号签名日期 更改 数量更改单号签名日期 更改 | | | 更改 更改 更改 标记 标记 标记 | 数量更改单号 数量更改单号 数量更改单号 | | 签名 签名日期 更改标记 数量更改单号 签名 签名日期 更改标记 数量更改单号 签名 签名日期 更改标记 数量更改单号 | 日期 日期 日期
拟制 拟制 拟制 | | Jason.Wang Jason.Wang Jason.Wang | LVDS LVDS LVDS | | | ITR-201C ITR-201C ITR-201C
审核 审核 审核 | | <审核> <审核> <审核>

D | D

## Enable Far-End Fault

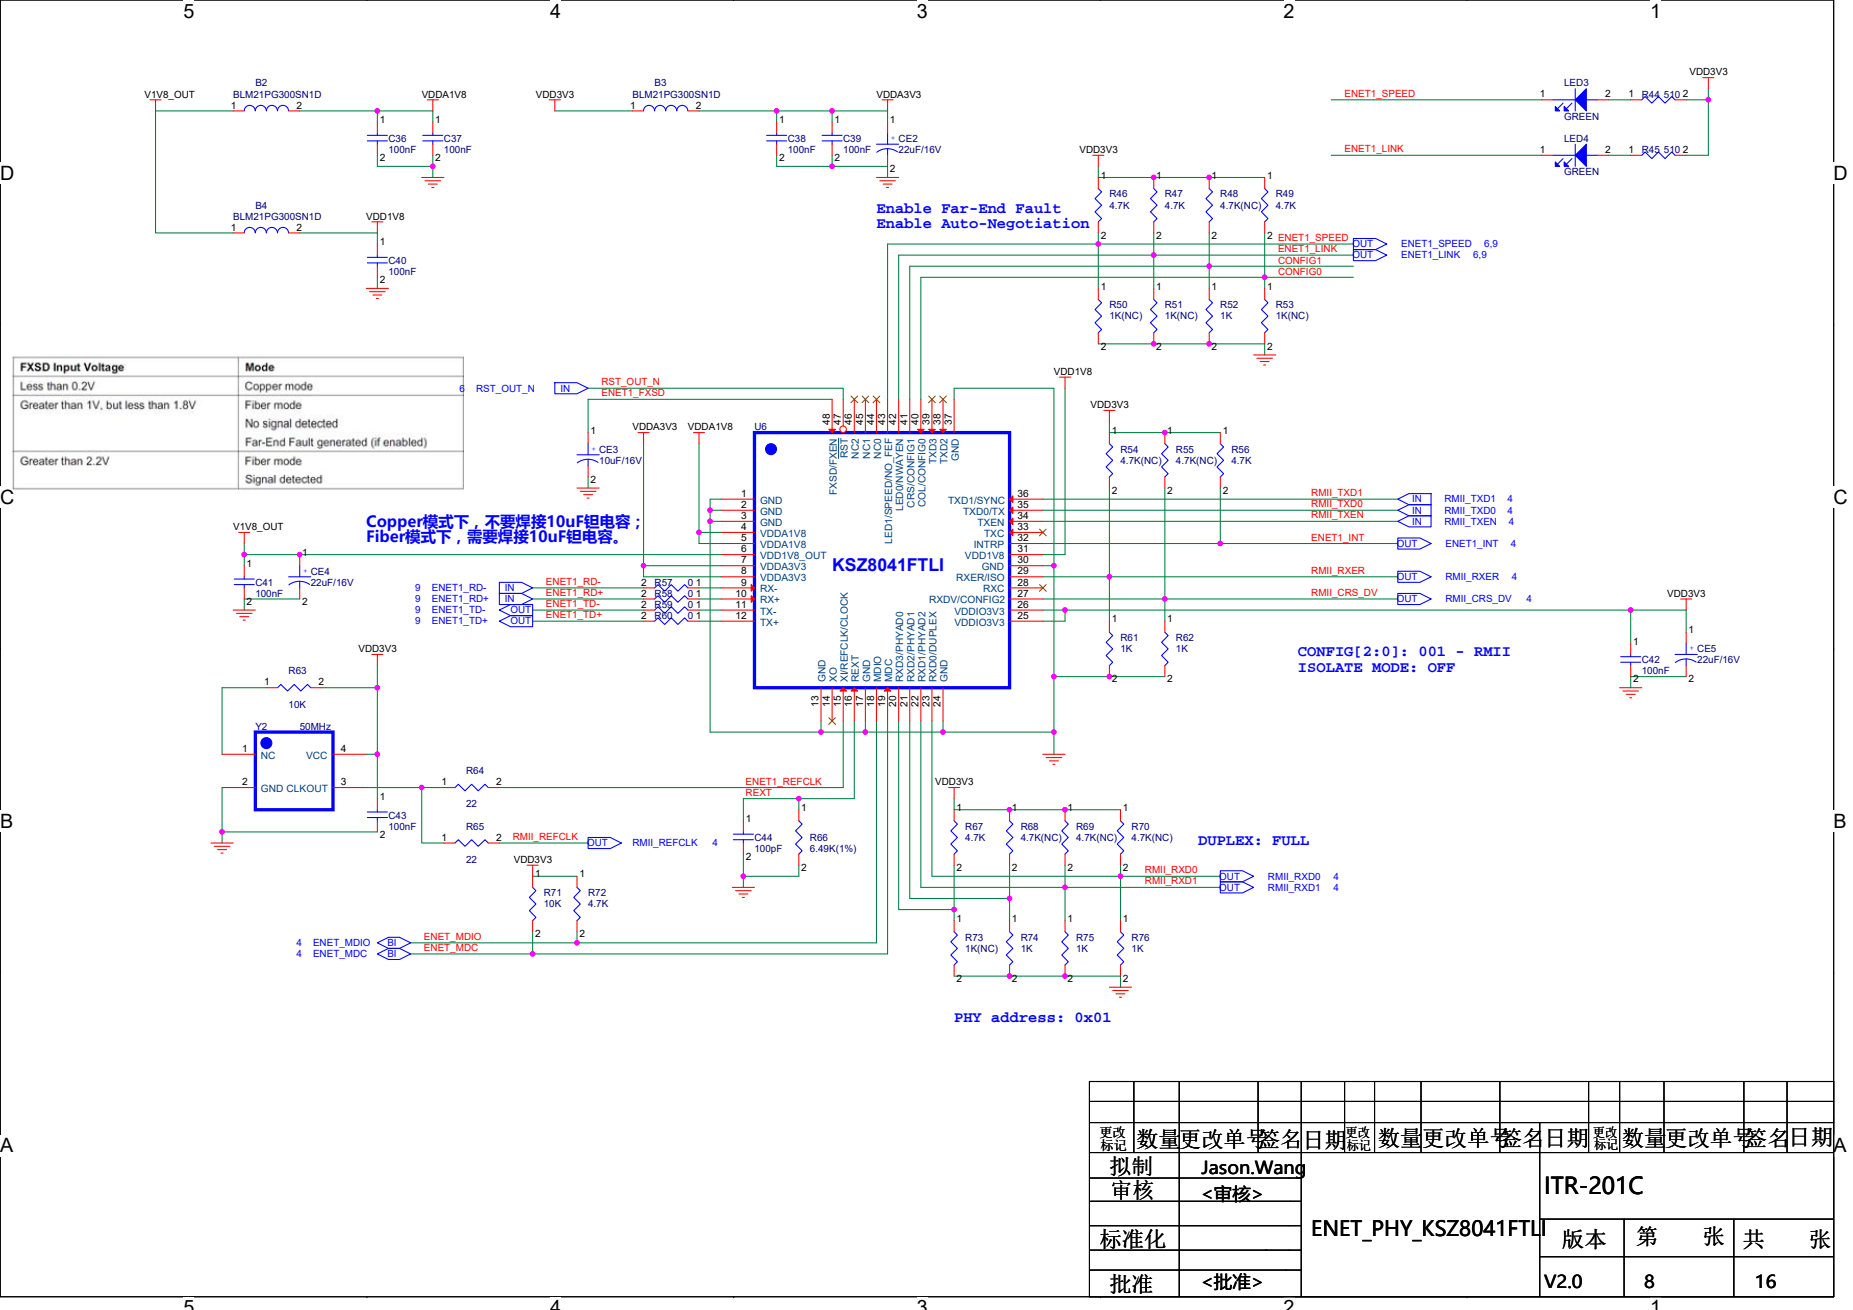
[picture p13: page 8]

标记 标记 标记 | 数量更改单号签名日期 更改 数量更改单号签名日期 更改 数量更改单号签名日期 更改 | | 更改 更改 更改 标记 标记 标记 | 数量更改单号 数量更改单号 数量更改单号 | | 签名 签名日期 更改标记 数量更改单号 签名 签名日期 更改标记 数量更改单号 签名 签名日期 更改标记 数量更改单号 | 日期 日期 日期
拟制 拟制 拟制 | | Jason.Wang Jason.Wang Jason.Wang | | | ITR-201C ITR-201C ITR-201C
审核 审核 审核 | | <审核> <审核> <审核>

D | D

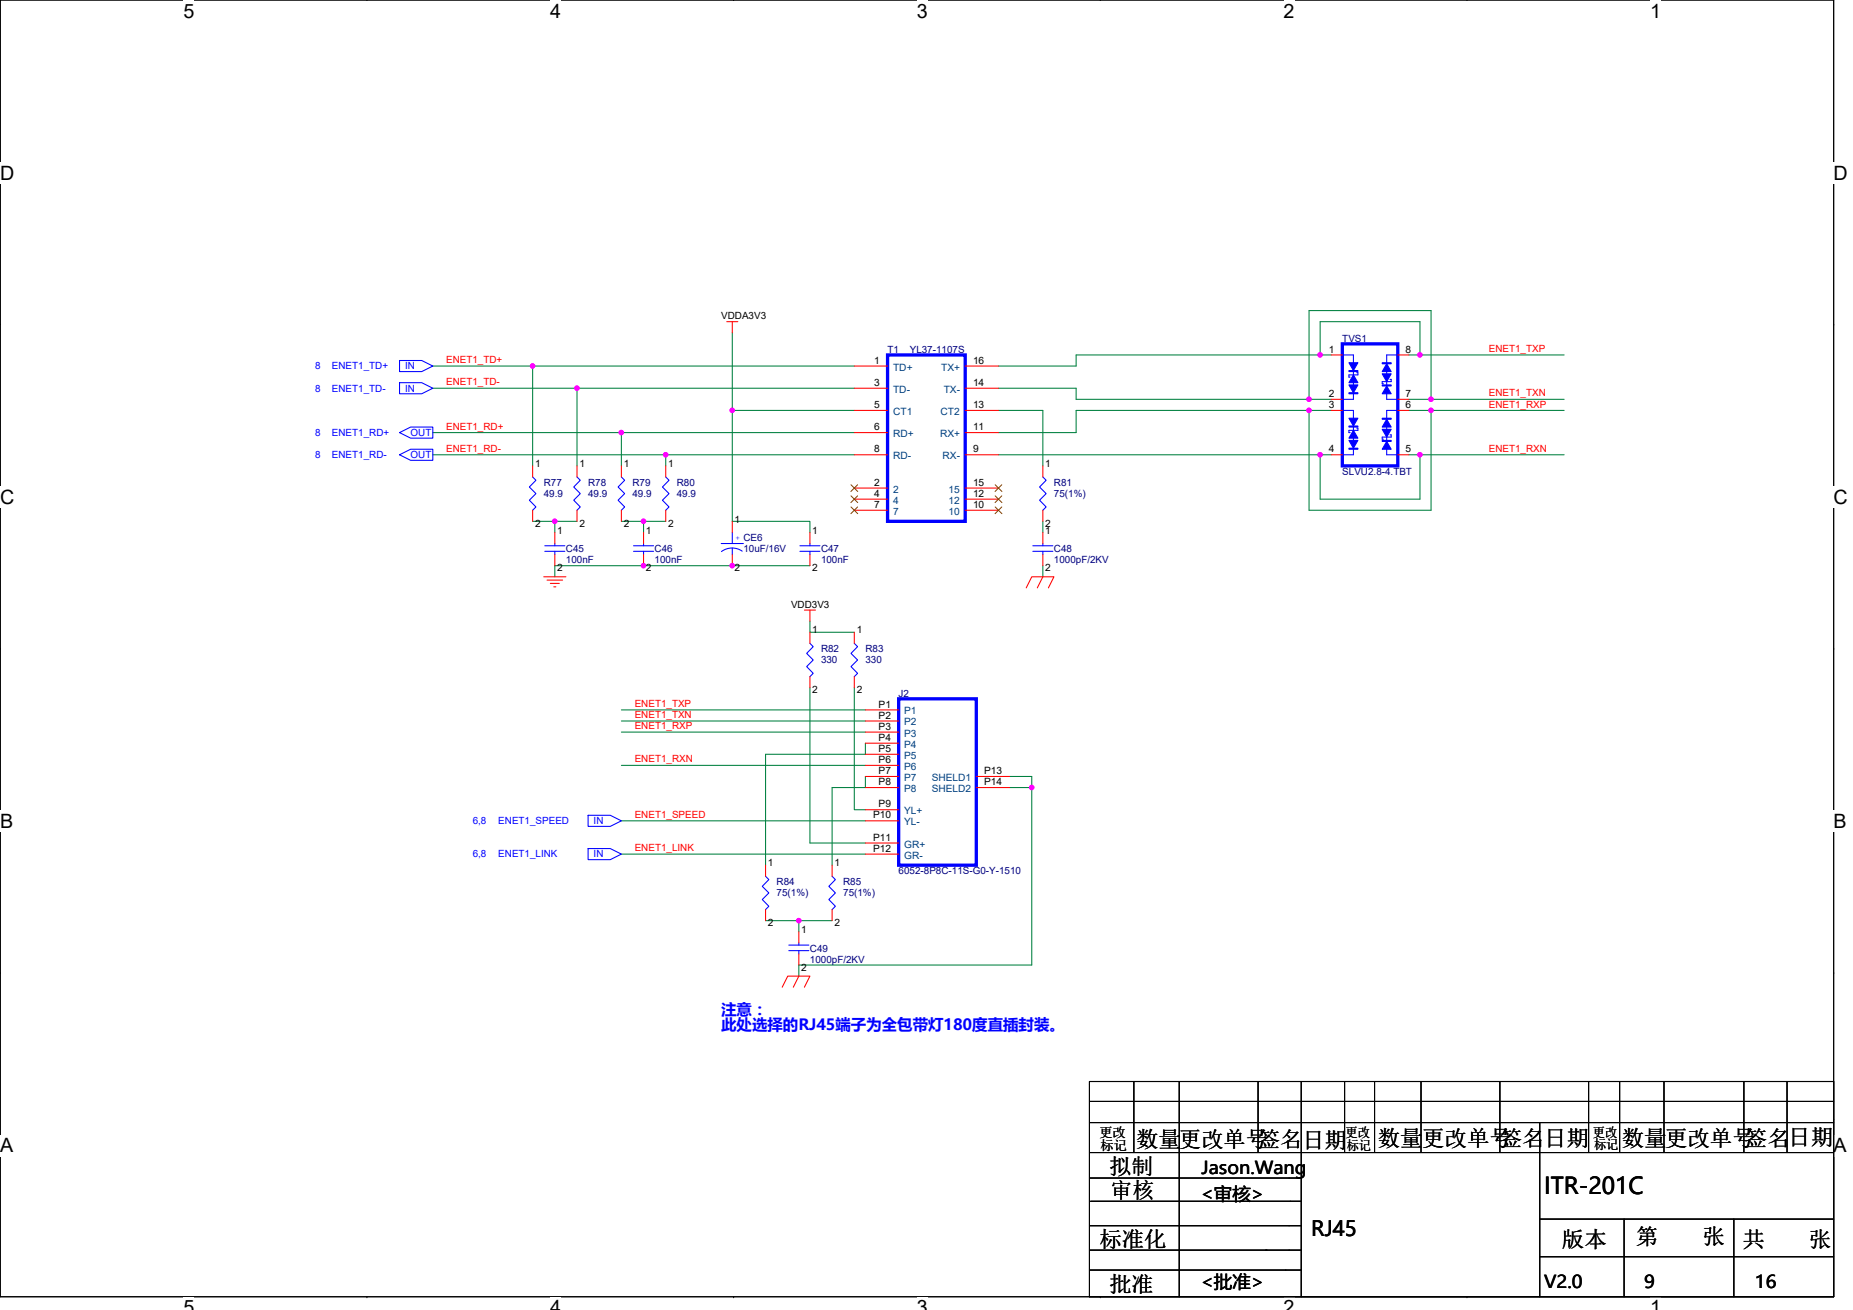
[picture p14: page 9]

标记 标记 标记 | 数量更改单号签名日期 更改 数量更改单号签名日期 更改 数量更改单号签名日期 更改 | | | 更改 更改 更改 标记 标记 标记 | 数量更改单号 数量更改单号 数量更改单号 | | 签名 签名日期 更改标记 数量更改单号 签名 签名日期 更改标记 数量更改单号 签名 签名日期 更改标记 数量更改单号 | 日期 日期 日期
拟制 拟制 拟制 | | Jason.Wang Jason.Wang Jason.Wang | RJ45 RJ45 RJ45 | | | ITR-201C ITR-201C ITR-201C
审核 审核 审核 | | <审核> <审核> <审核>

D | D

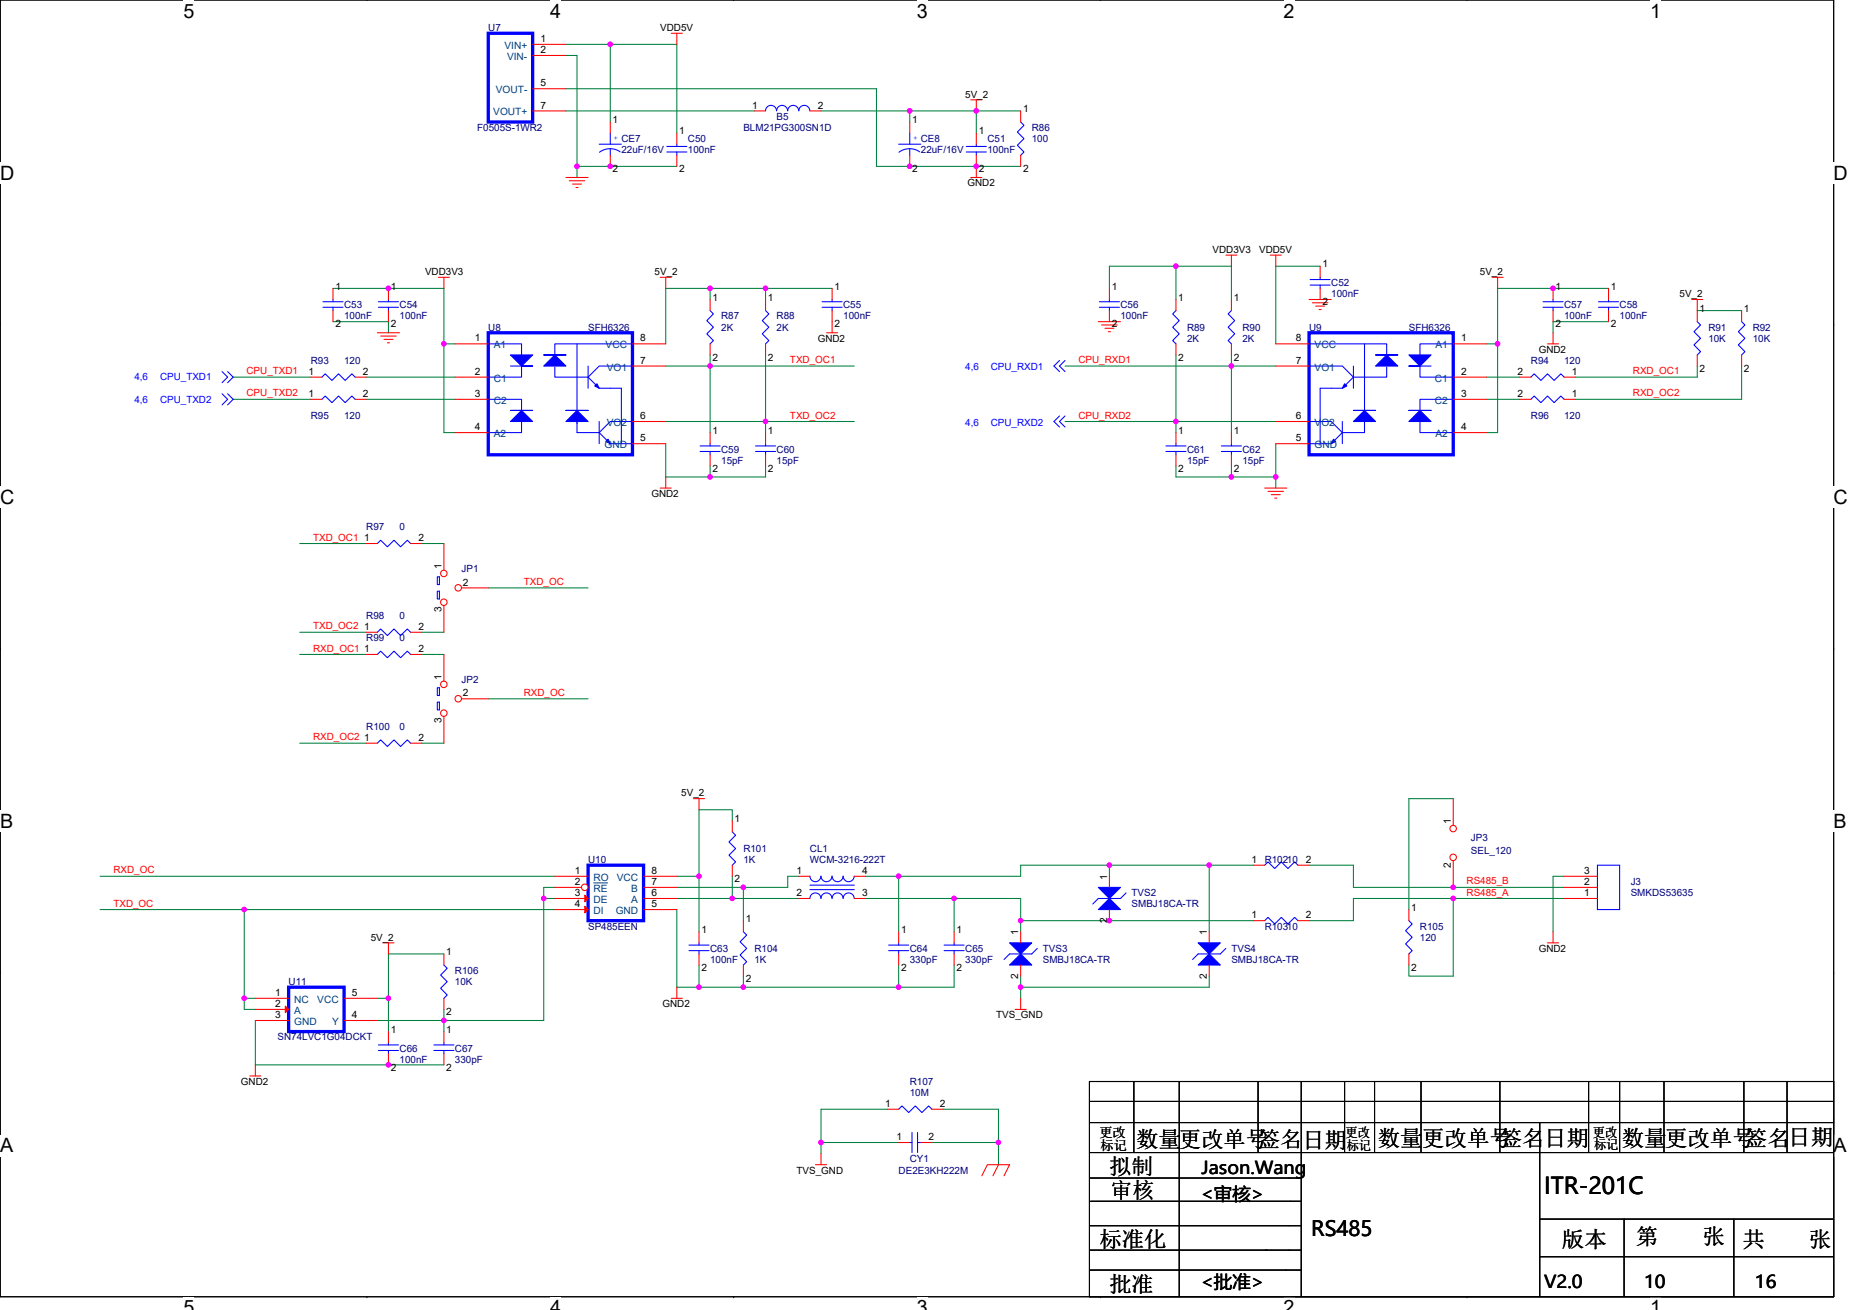
[picture p15: page 10]

标记 标记 标记 | 数量更改单号签名日期 更改 数量更改单号签名日期 更改 数量更改单号签名日期 更改 | | | 更改 更改 更改 标记 标记 标记 | 数量更改单号 数量更改单号 数量更改单号 | | 签名 签名日期 更改标记 数量更改单号 签名 签名日期 更改标记 数量更改单号 签名 签名日期 更改标记 数量更改单号 | 日期 日期 日期
拟制 拟制 拟制 | | Jason.Wang Jason.Wang Jason.Wang | RS485 RS485 RS485 | | | ITR-201C ITR-201C ITR-201C
审核 审核 审核 | | <审核> <审核> <审核>

D | D

# 本设计默认采用奥松的AM2301采集模块

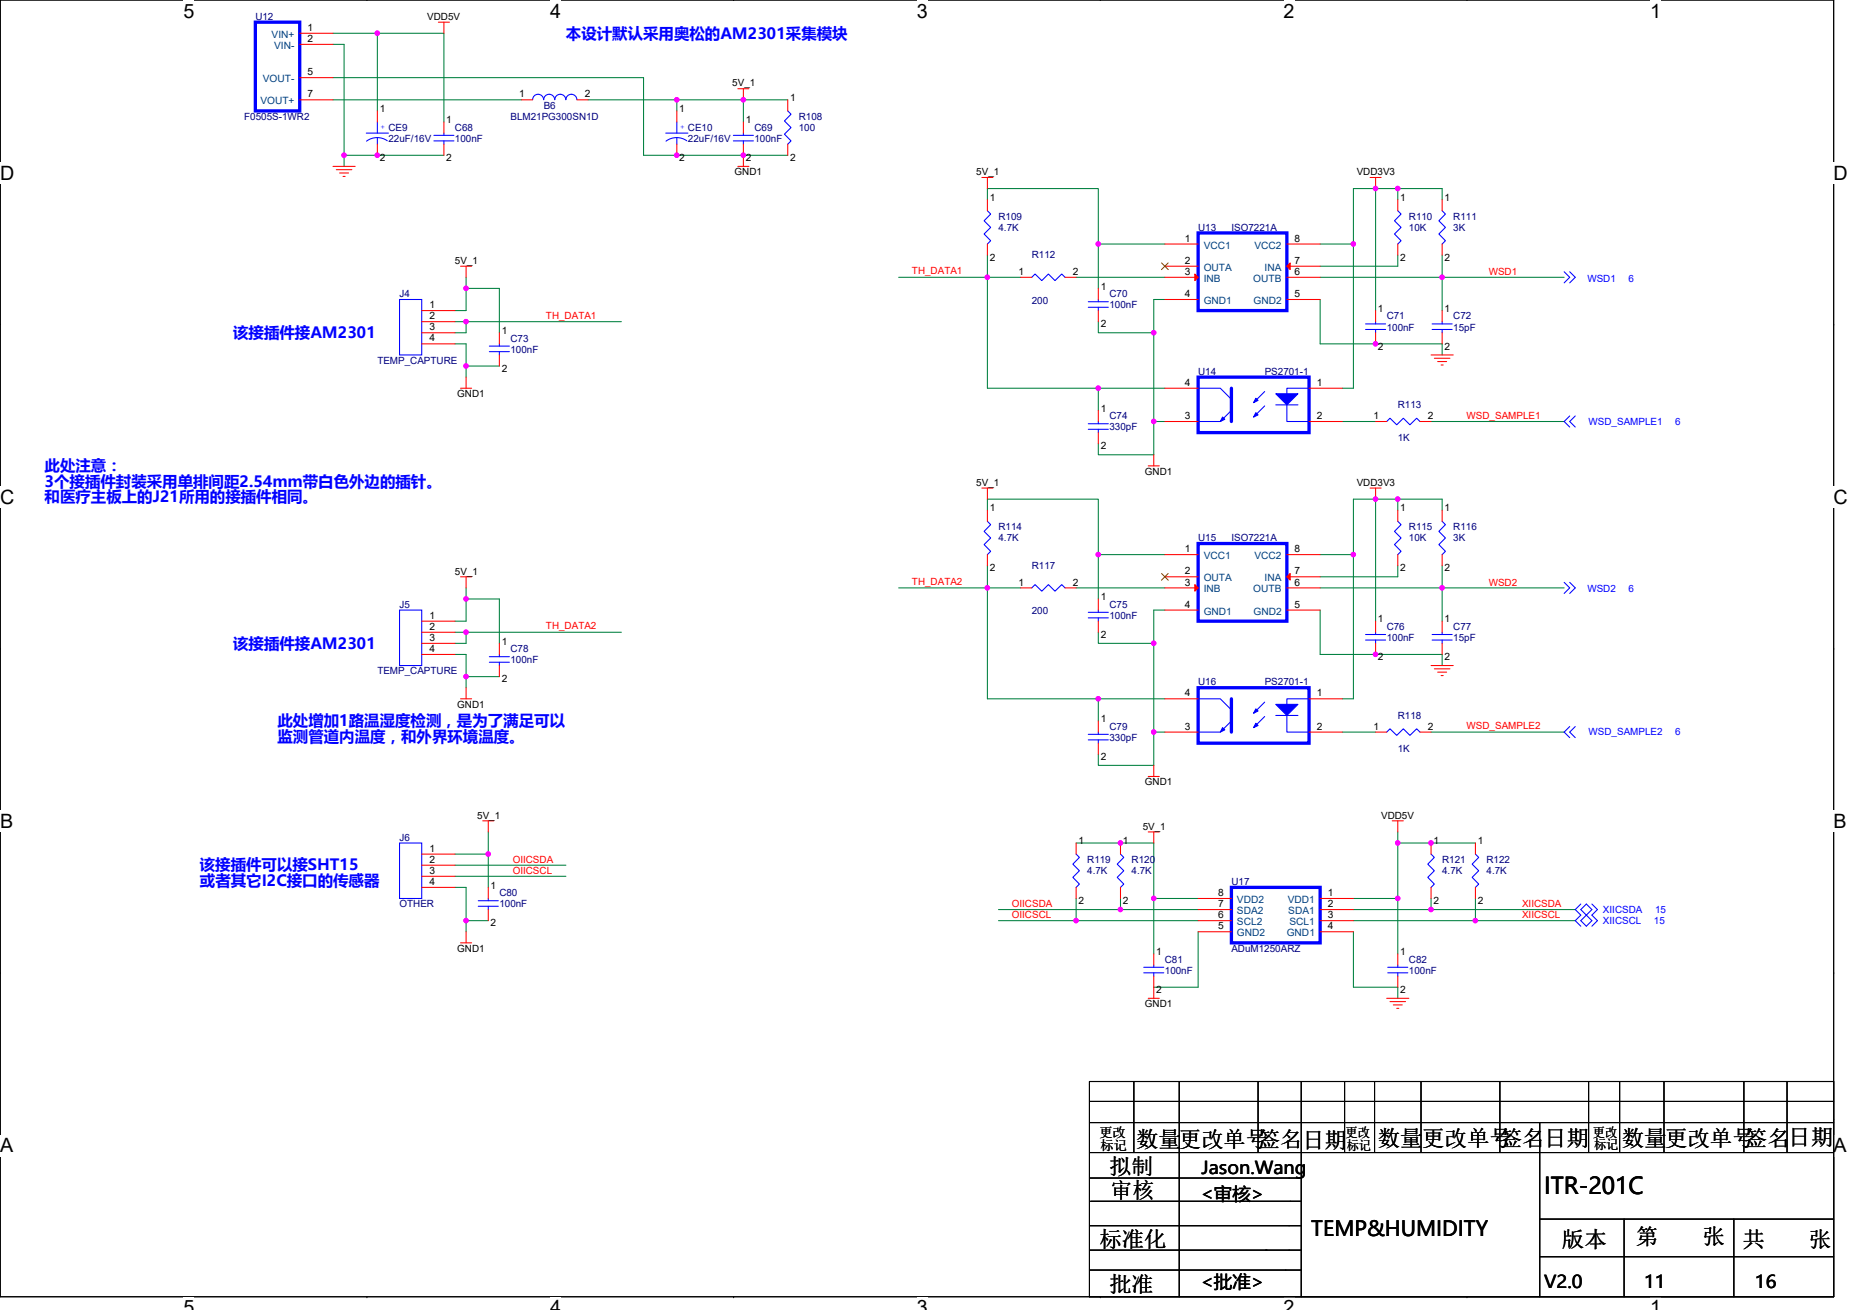
[picture p16: page 11]

标记 标记 标记 | 数量更改单号签名日期 更改 数量更改单号签名日期 更改 数量更改单号签名日期 更改 | | | 更改 更改 更改 标记 标记 标记 | 数量更改单号 数量更改单号 数量更改单号 | | 签名 签名日期 更改标记 数量更改单号 签名 签名日期 更改标记 数量更改单号 签名 签名日期 更改标记 数量更改单号 | 日期 日期 日期
拟制 拟制 拟制 | | Jason.Wang Jason.Wang Jason.Wang | TEMP&HUMIDITY TEMP&HUMIDITY TEMP&HUMIDITY | | | ITR-201C ITR-201C ITR-201C
审核 审核 审核 | | <审核> <审核> <审核>

D | D

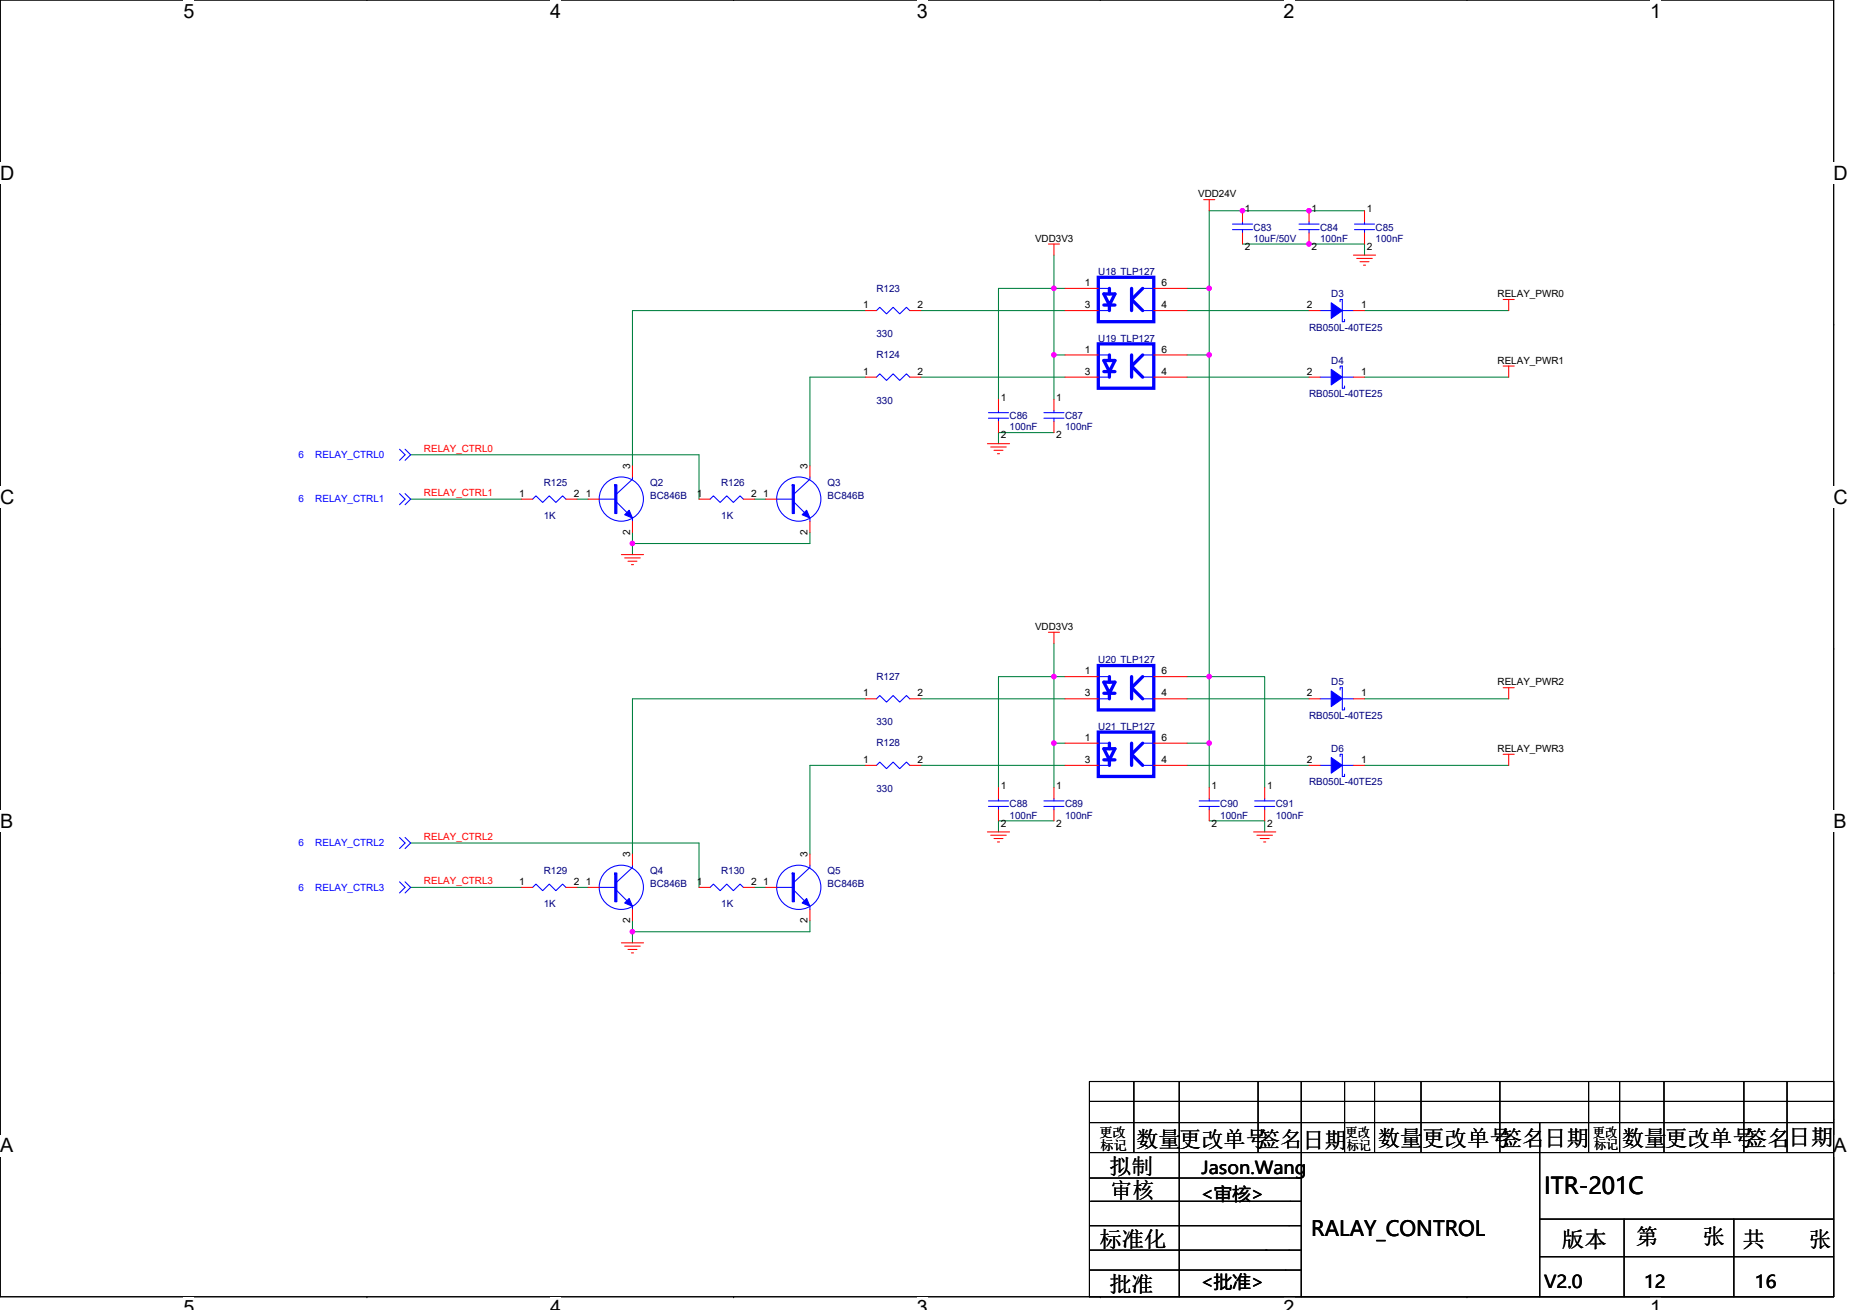
[picture p17: page 12]

标记 标记 标记 | 数量更改单号签名日期 更改 数量更改单号签名日期 更改 数量更改单号签名日期 更改 | | | 更改 更改 更改 标记 标记 标记 | 数量更改单号 数量更改单号 数量更改单号 | | 签名 签名日期 更改标记 数量更改单号 签名 签名日期 更改标记 数量更改单号 签名 签名日期 更改标记 数量更改单号 | 日期 日期 日期
拟制 拟制 拟制 | | Jason.Wang Jason.Wang Jason.Wang | RALAY_CONTROL RALAY_CONTROL RALAY_CONTROL | | | ITR-201C ITR-201C ITR-201C
审核 审核 审核 | | <审核> <审核> <审核>

D | D
L

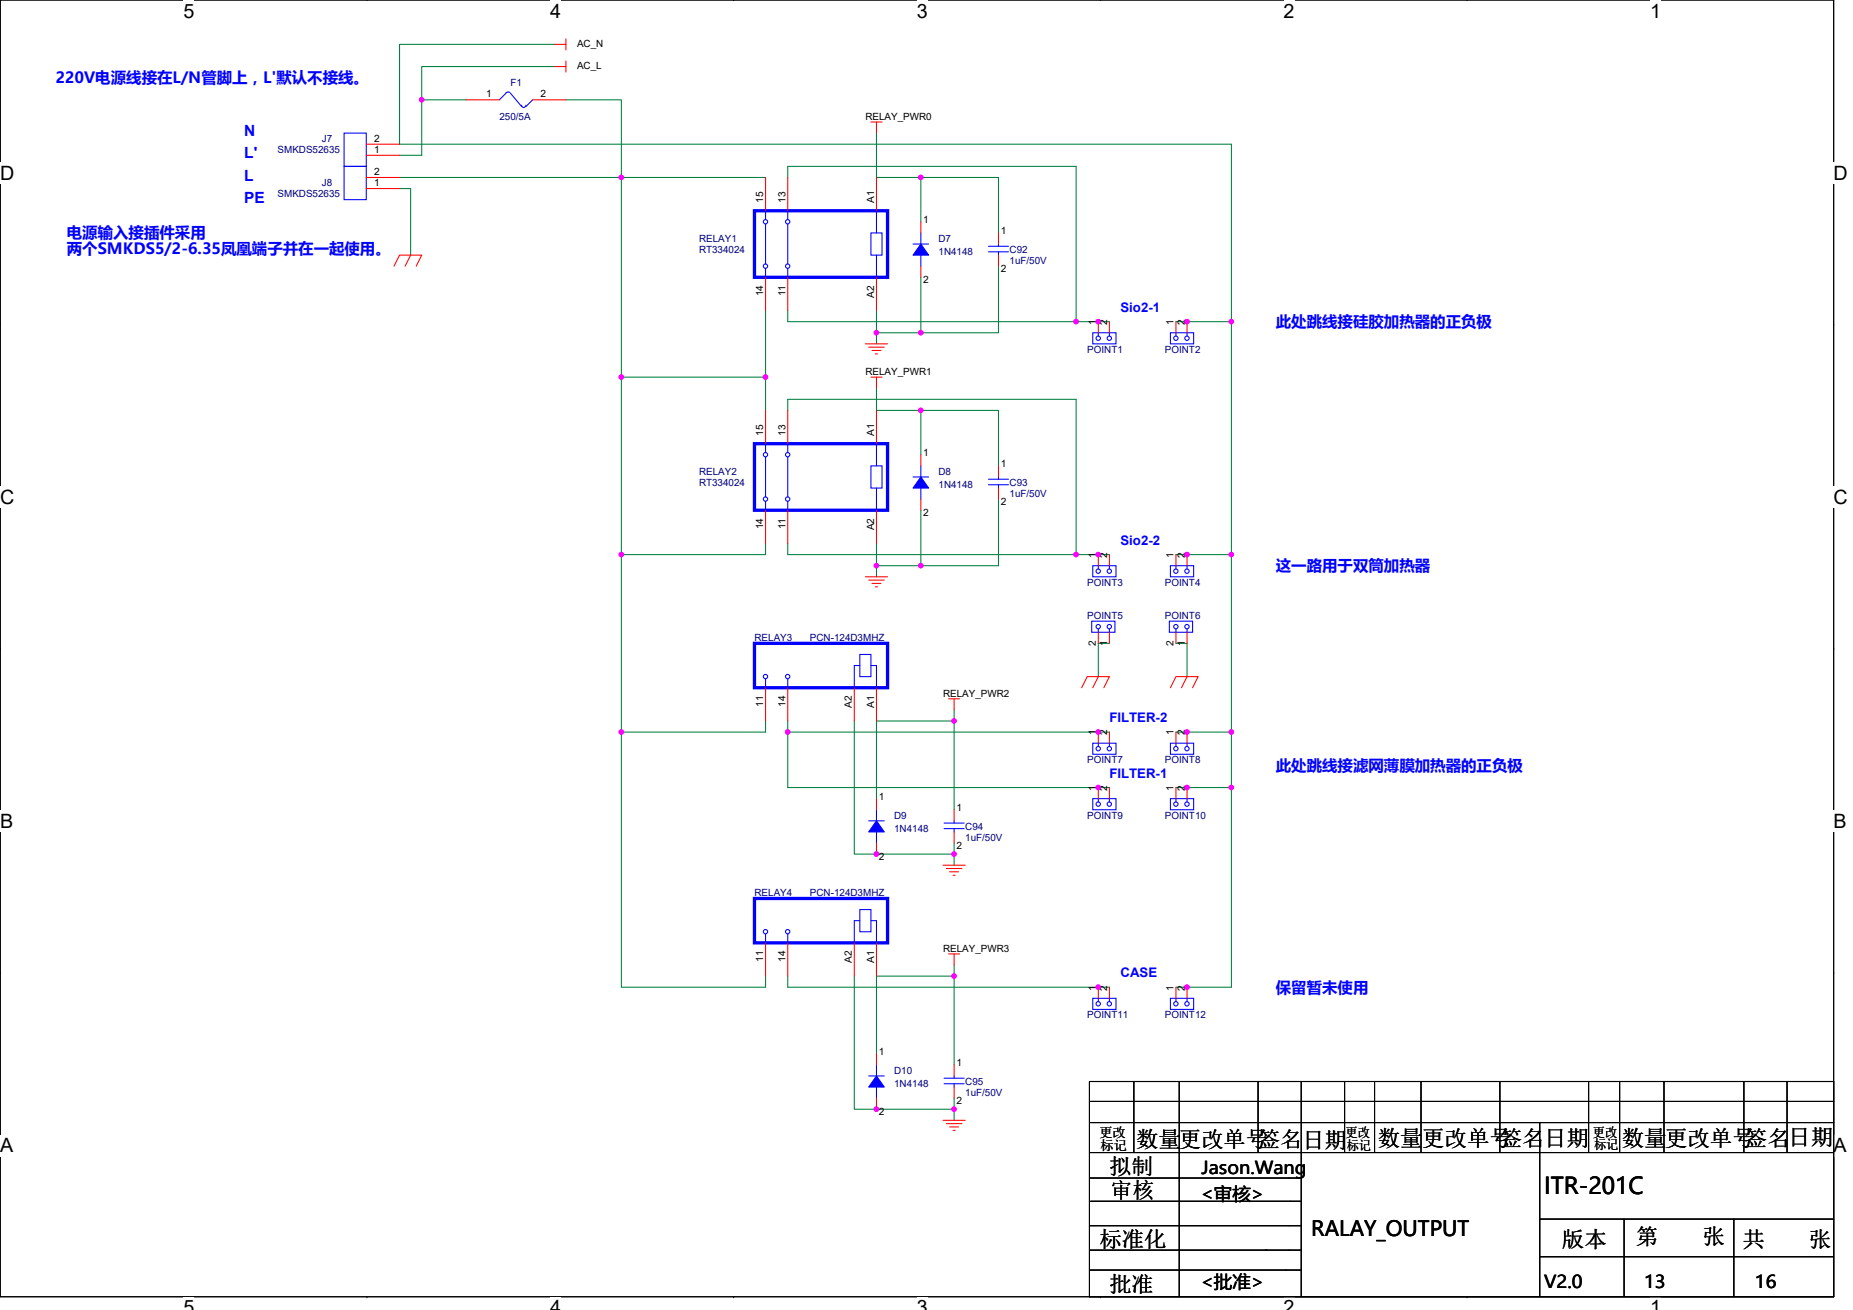
[picture p18: page 13]

标记 标记 标记 | 数量更改单号签名日期 更改 数量更改单号签名日期 更改 数量更改单号签名日期 更改 | | | 更改 更改 更改 标记 标记 标记 | 数量更改单号 数量更改单号 数量更改单号 | | 签名 签名日期 更改标记 数量更改单号 签名 签名日期 更改标记 数量更改单号 签名 签名日期 更改标记 数量更改单号 | 日期 日期 日期
拟制 拟制 拟制 | | Jason.Wang Jason.Wang Jason.Wang | RALAY_OUTPUT RALAY_OUTPUT RALAY_OUTPUT | | | ITR-201C ITR-201C ITR-201C
审核 审核 审核 | | <审核> <审核> <审核>

D | D

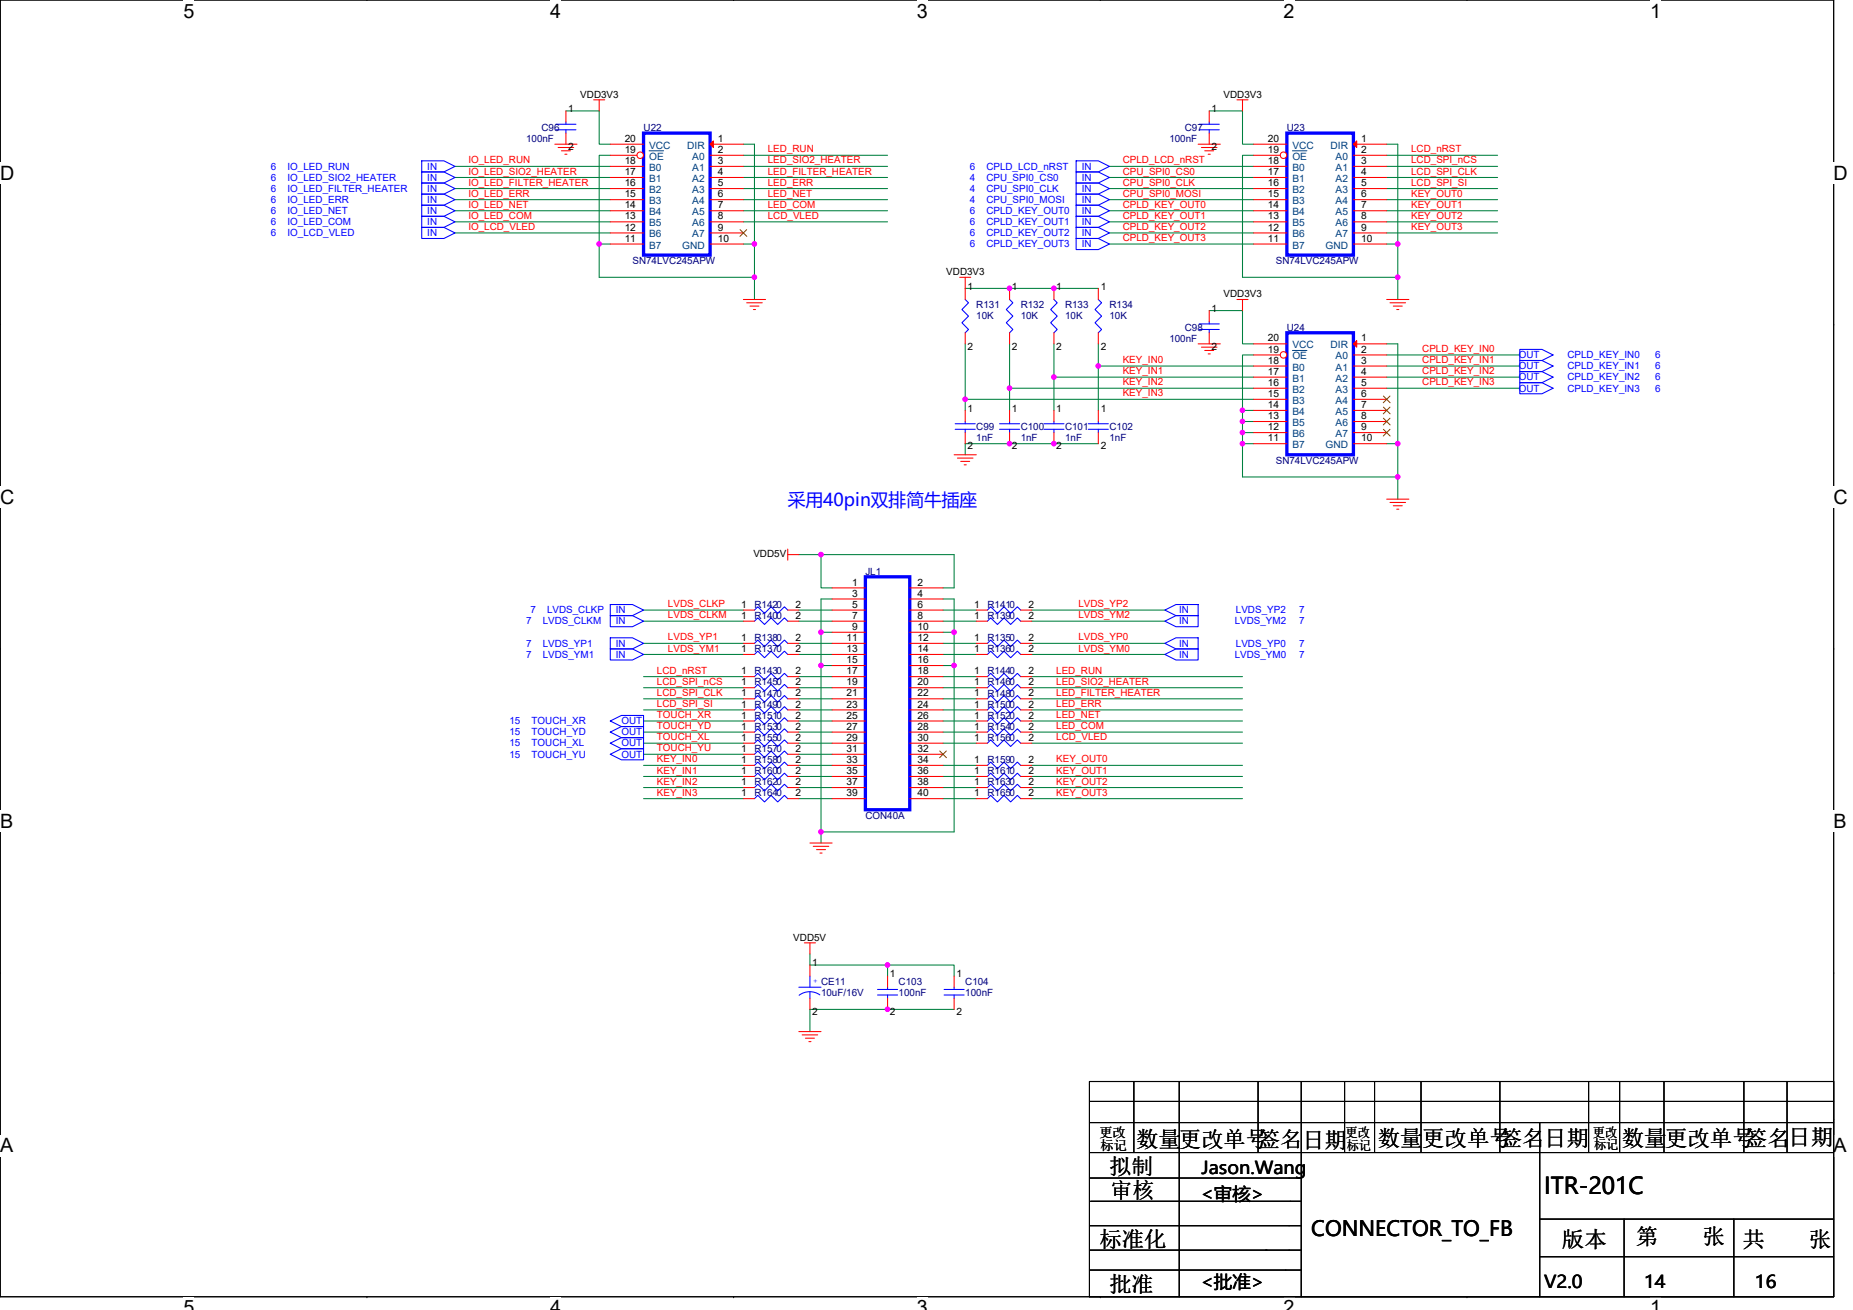
[picture p19: page 14]

KEY_IN2
KEY_IN3

标记 标记 标记 | 数量更改单号签名日期 更改 数量更改单号签名日期 更改 数量更改单号签名日期 更改 | | | 更改 更改 更改 标记 标记 标记 | 数量更改单号 数量更改单号 数量更改单号 | | 签名 签名日期 更改标记 数量更改单号 签名 签名日期 更改标记 数量更改单号 签名 签名日期 更改标记 数量更改单号 | 日期 日期 日期
拟制 拟制 拟制 | | Jason.Wang Jason.Wang Jason.Wang | CONNECTOR_TO_FB CONNECTOR_TO_FB CONNECTOR_TO_FB | | | ITR-201C ITR-201C ITR-201C
审核 审核 审核 | | <审核> <审核> <审核>

D | D

# 调试串口

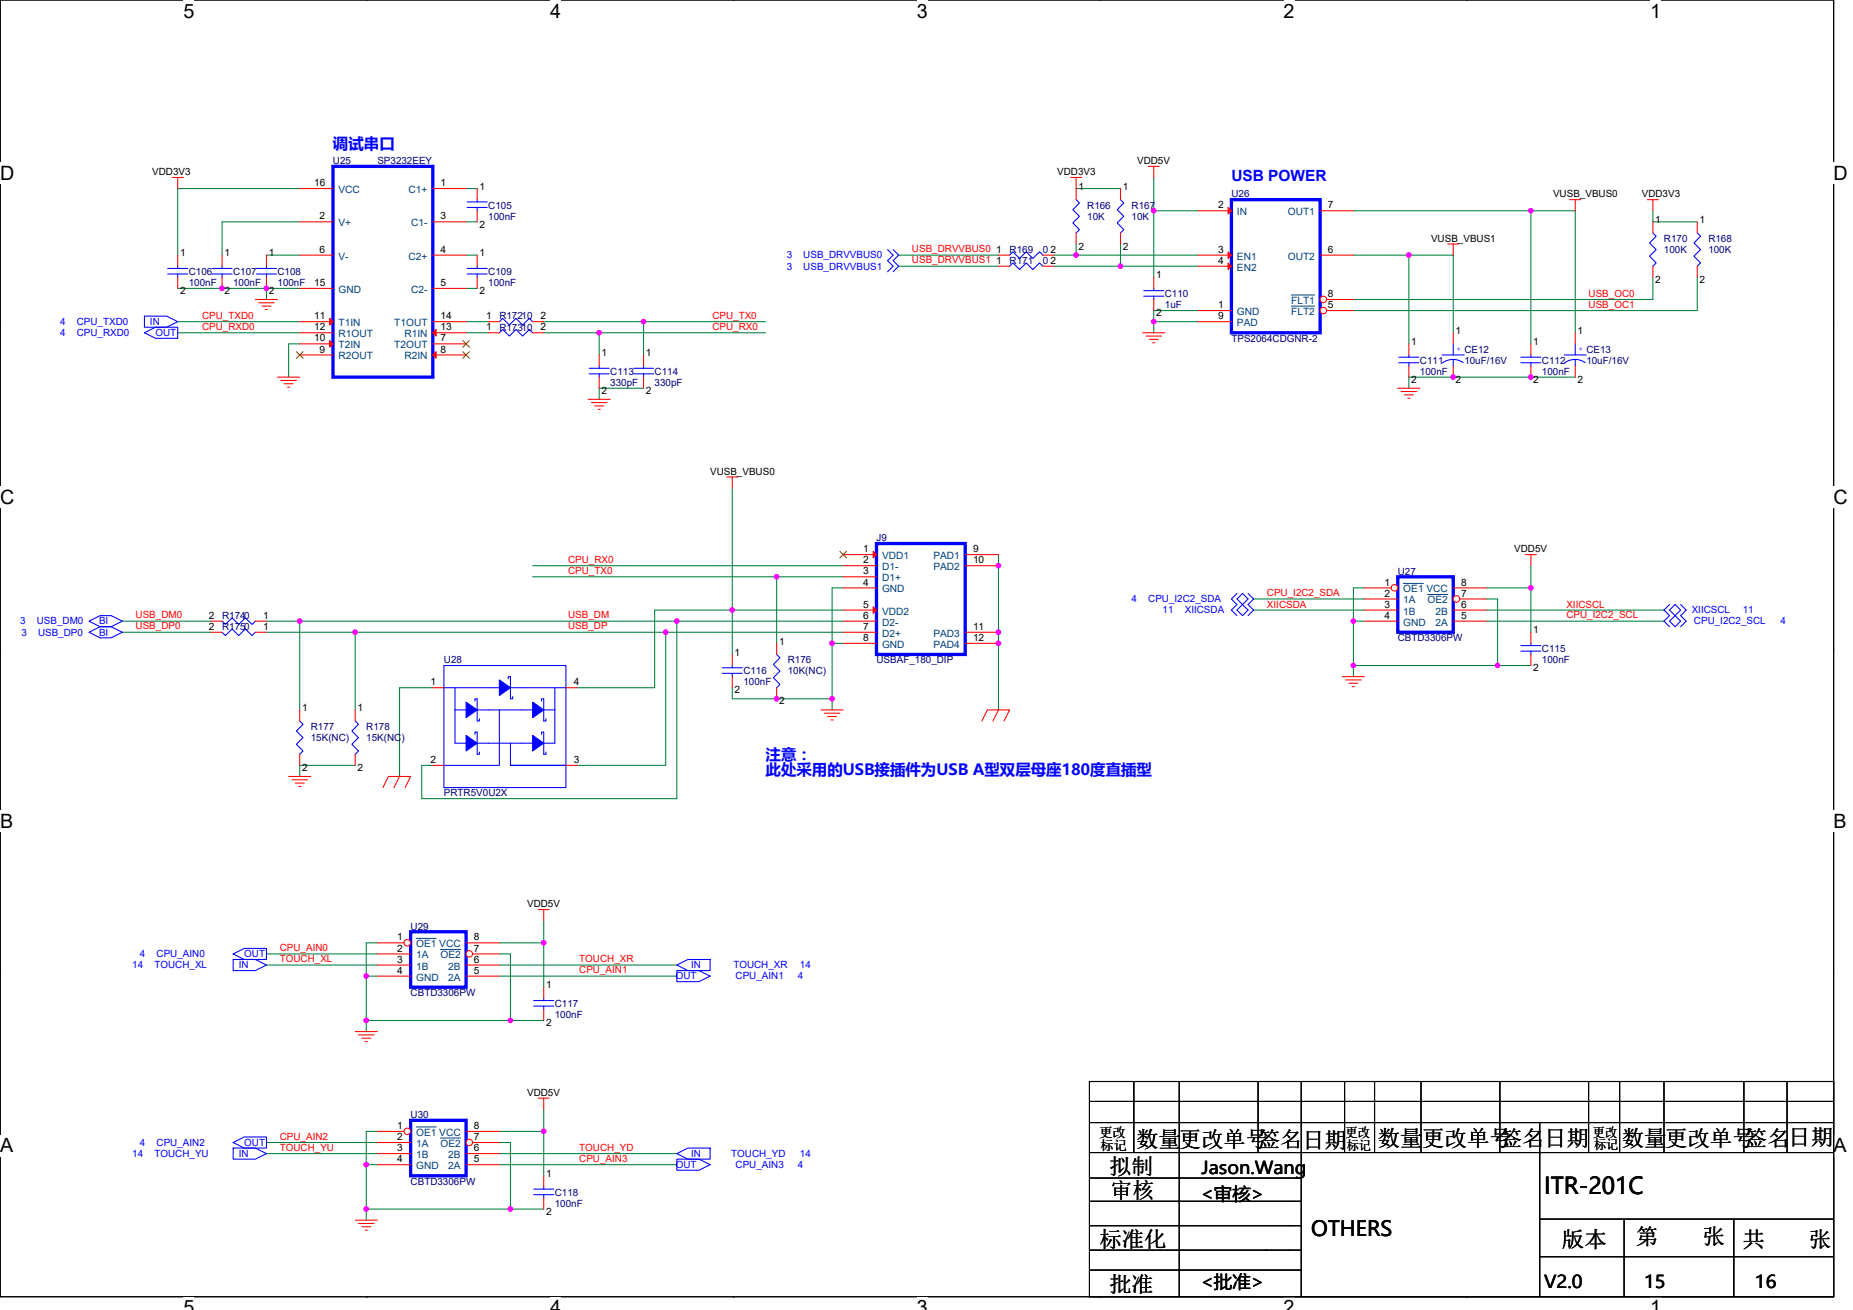
[picture p20: page 15]

C110 | EN1 3 EN2 4 GND 1 | VUSB_VBUS1

USB_OC1

PAD 9 | 1

D | D

# 蓝色粗线要求布线线宽80mil。

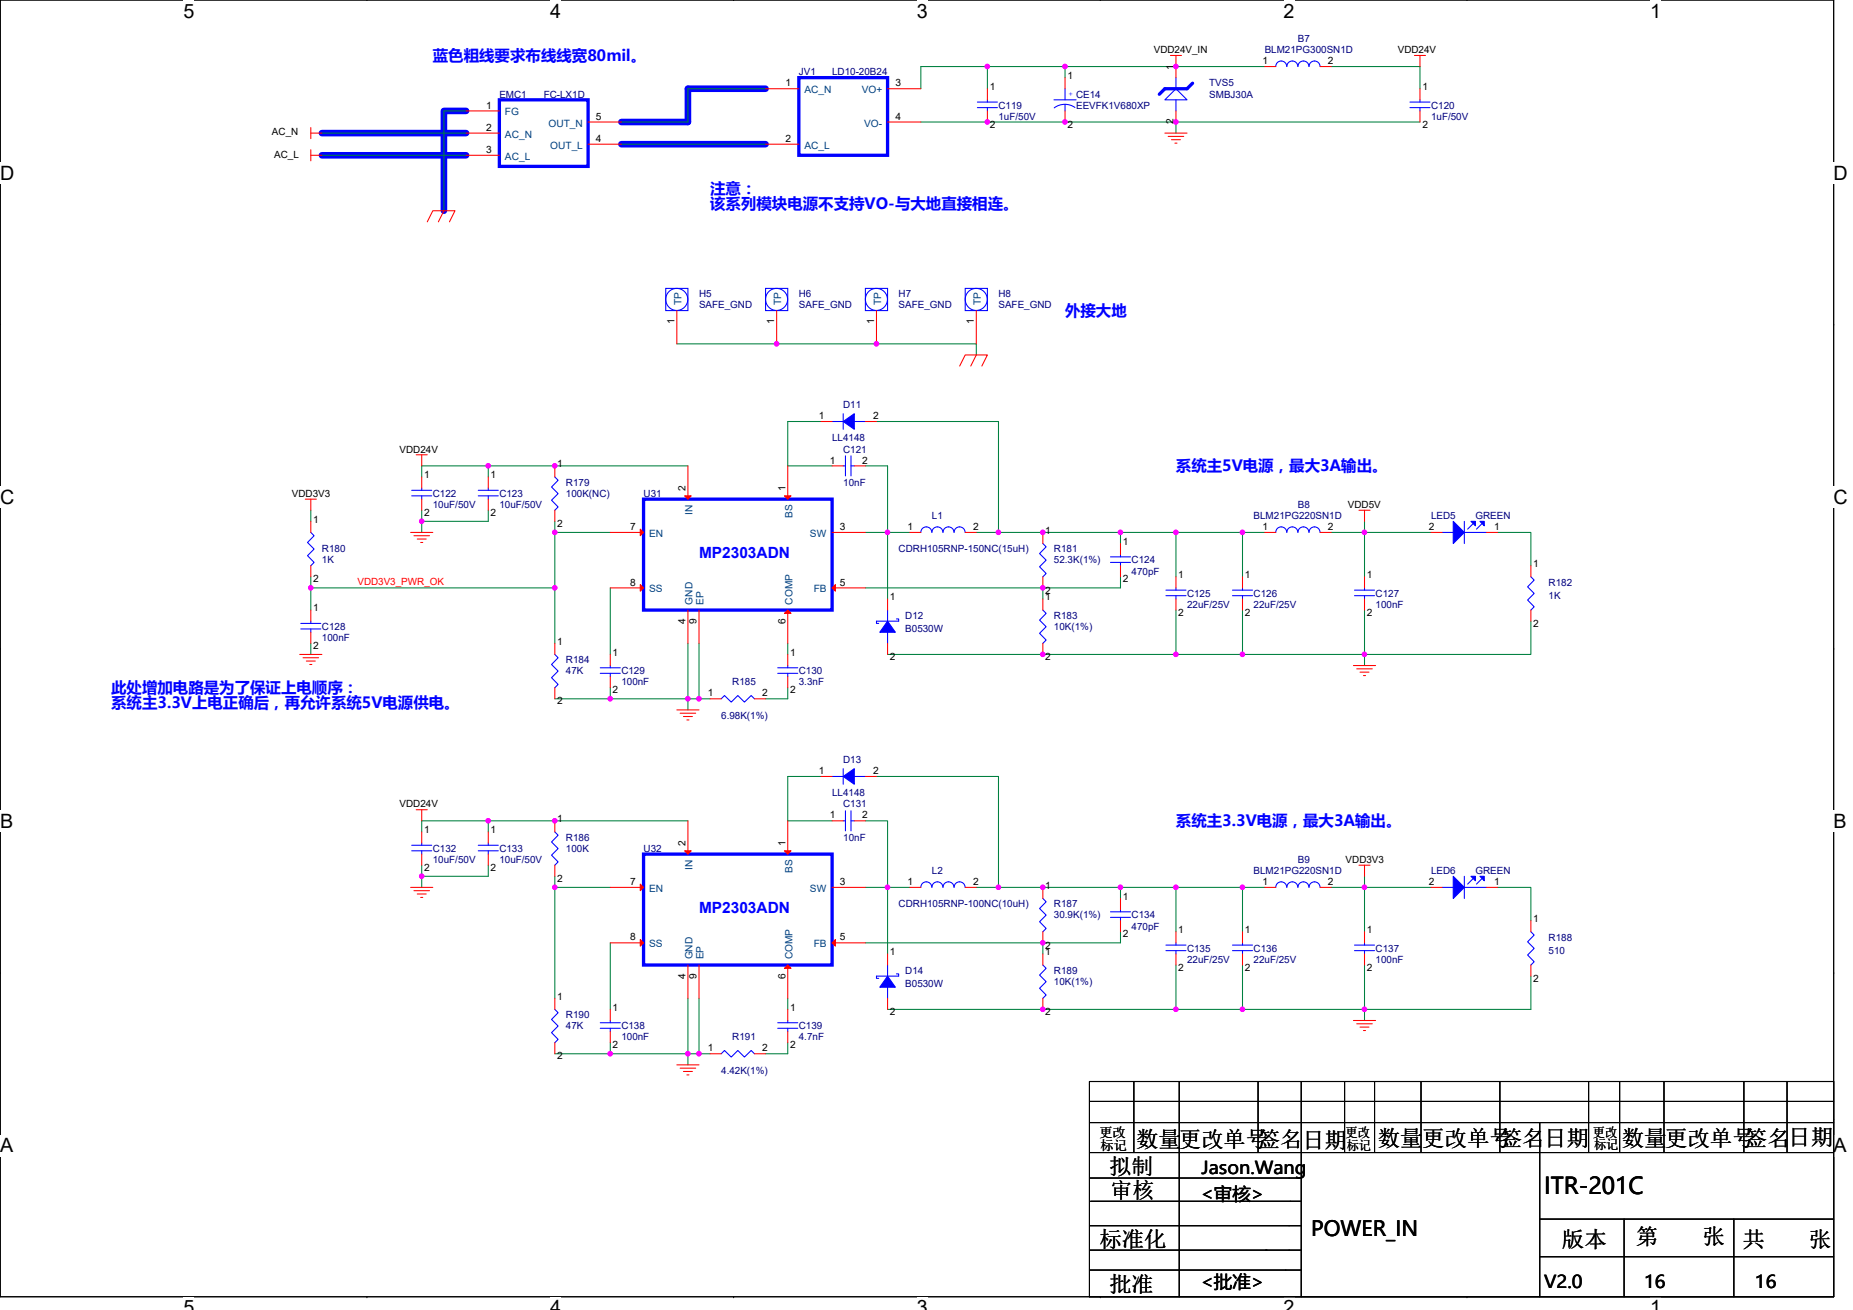
[picture p21: page 16]

标记 标记 标记 | 数量更改单号签名日期 更改 数量更改单号签名日期 更改 数量更改单号签名日期 更改 | | | 更改 更改 更改 标记 标记 标记 | 数量更改单号 数量更改单号 数量更改单号 | | 签名 签名日期 更改标记 数量更改单号 签名 签名日期 更改标记 数量更改单号 签名 签名日期 更改标记 数量更改单号 | 日期 日期 日期
拟制 拟制 拟制 | | Jason.Wang Jason.Wang Jason.Wang | POWER_IN POWER_IN POWER_IN | | | ITR-201C ITR-201C ITR-201C
审核 审核 审核 | | <审核> <审核> <审核>
