gdgly/itr-201c/结构图_161019/ITR-201C_FB.pdf

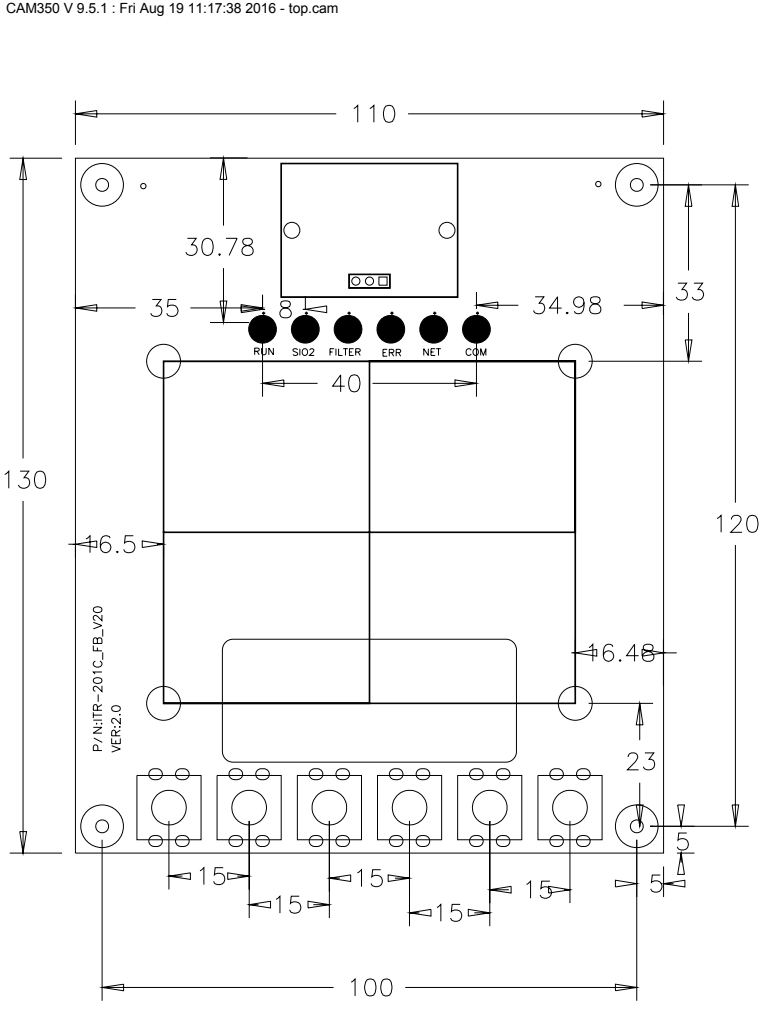
[picture p22: page 1]

CAM350 V 9.5.1 : Fri Aug 19 11:17:38 2016 - top.cam
