gdgly/itr-201c/(list of files, drawings)

Other design files:
SCH_160725/ITR-201C_FB_V20_160725/ITR-201C_FB.DSN
SCH_160725/ITR-201C_FB_V20_160725/ITR-201C_FB.opj
SCH_160725/ITR-201C_MB_V20_160727/ITR-201C_MB.DSN
SCH_160725/ITR-201C_MB_V20_160727/ITR-201C_MB.opj
