gdgly/itr-201c/(commit log)

2016-08-02 免维护呼吸器硬件设计源码，V2.0版本。
    [ITR-201C_FB.DSN, ITR-201C_FB.csv, ITR-201C_FB.opj, ITR-201C_MB.DSN, ITR-201C_MB.csv, ITR-201C_MB.opj, itr_201c.smp_dump.txt]
2016-08-02 测试分支，打开一次CPLD系统文件，但未作任何修改。
2016-08-02 又进行一次编译版本
2016-08-04 修改了FB板原理图： 1、将液晶屏接插件和触摸屏接插件的原理图封装做了修改，分别增加了PAD1和PAD2两个管脚，以保持和FPC接插件的管脚一致。这两个管脚均接地。 2、增加两个接插件的封装命令，均为FPC接插件，液晶屏接插件为间距0.5mm，触摸屏接插件间距为1.0mm。
    [ITR-201C_FB.DSN, ITR-201C_FB.opj]
2016-08-04 修改了MB板和FB原理图，功能上没有改动，主要是为了便于PCB板布线，更改40pin板对板接插件上差分线的定义。
    [ITR-201C_FB.DSN, ITR-201C_FB.opj, ITR-201C_MB.DSN, ITR-201C_MB.opj]
2016-08-12 2016年8月12日：修改了FB上40pin接插件上的查分信号的定义，将YP0+/YP0-和YP2+/YP2-颠倒了一下，以保持和MB上的定义完全一致。
    [ITR-201C_FB.DSN, ITR-201C_FB.opj]
2016-09-08 2016年9月8日：硬件测试阶段，修改了CPLD程序。 本次修改主要修正了蜂鸣器声音频率的问题。
2016-09-12 2016年9月12日：修改了CPLD程序中矩阵键盘逻辑，增加了键盘消抖代码，并将这块逻辑单独作为一个子模块实现：key_matrix_4x4.v。 测试程序/key.c是将南京瓦利特的键盘驱动程序拿来做一个参考。实际驱动代码中去掉了定时器实现。
2016-10-24 2016年10月24日： 按照任澍芃邮件中的要求，添加了ITB变压器智能呼吸器硬件说明.docx文档。 文档尚未完成，处于编辑开发状态。
    [ITR-201C_FB.dxf]
2016-10-24 2016年10月24日： 1、更新了“ITB变压器智能呼吸器硬件说明”文档。文档尚未最终完成。 2、建立了电控板上端子及接插件位置示意图的Visio文档。
