gdgly/itr-201c/DOC/20161024_153301.jpg

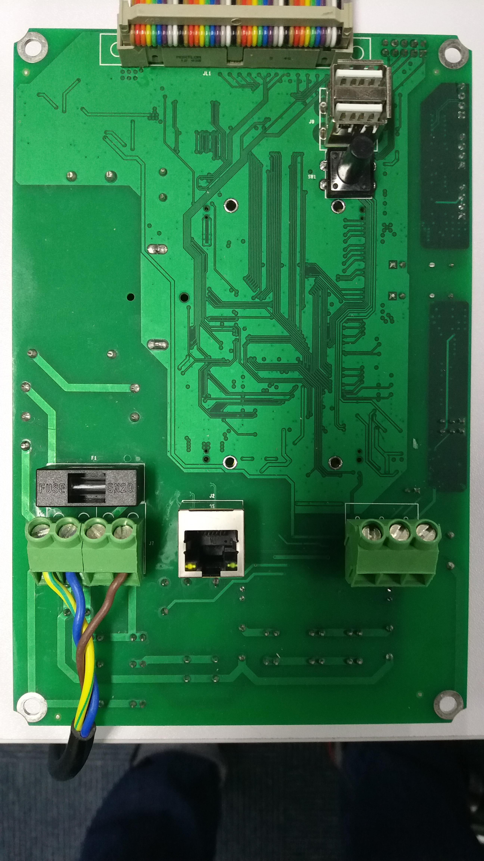
DOC/20161024_153301.jpg
